spaceleagueofjustice/MEMS_Earth_Rotation_Measurement/README.md

# MEMS_Earth_Rotation_Measurement
Cheapest Earth rotation measurement ever
