spaceleagueofjustice/MEMS_Earth_Rotation_Measurement/Project_Jirka/Diagrams/Configuration.pdf

## Problems Eliminated or Reduced by This Configuration

Ground loop interference | EMI generated by motor drivers
PWM switching noise coupling into IMU electronics | Shared power supply ripple
Voltage spikes from DC motors | Current surge induced sensor instability
Mechanical cable pulling artifacts | Rotating cable torsion effects
Slip ring electrical noise | USB ground coupling
Crosstalk between motor electronics and measurement electronics | Vibrations transferred through rigid cable harnesses
Electromagnetic contamination from H-bridges | ADC noise caused by shared motor power rails
Timing instability caused by | motor control interrupts | Sensor drift amplification caused by unstable supply voltage
Microphonic vibration artifacts inside MEMS structures | Mechanical asymmetry caused by external cable drag
Random motion induced by | dangling wires | Thermal coupling between power electronics and sensors
Electrical transients during motor startup/shutdown | High-frequency switching harmonics from PWM drivers
Noise injection through common GND reference | Synchronization errors caused by mixed control and
Data corruption caused by noisy motor environments | measurement tasks
Mechanical resonance amplification through shared chassis elements | Magnetic field disturbances generated by nearby motors
Reduced long-term stability caused by mixed analog/digital | Partial elimination of non-measurement-related systematic
noise sources | actuator activity
Environmental contamination of measurements caused by uncontrolled | Improved separation between measurement domain and
artifacts | actuation domain
Improved statistical purity of | long-term MEMS measurements | Improved repeatability of experimental conditions
Improved platform symmetry and inertial balance | Reduced risk of false correlated signals between sensor axes
Reduced probability of interpreting actuator artifacts as physical phenomena | Reduced influence of power-stage thermal drift on sensor
Reduced conducted noise inside sensitive IMU circuitry | readings
Reduced structural vibration | propagation into the gyro platform | Improved conditions for FFT analysis and long-term drift
Improved suitability for Allan | variance measurements | analysis
Improved suitability for ultra-low-frequency signal analysis | Improved separation of local artifacts from potentially
global/systemic effects
