spaceleagueofjustice/MEMS_Earth_Rotation_Measurement/Project_Jaroslav/Circuit/circuit.png

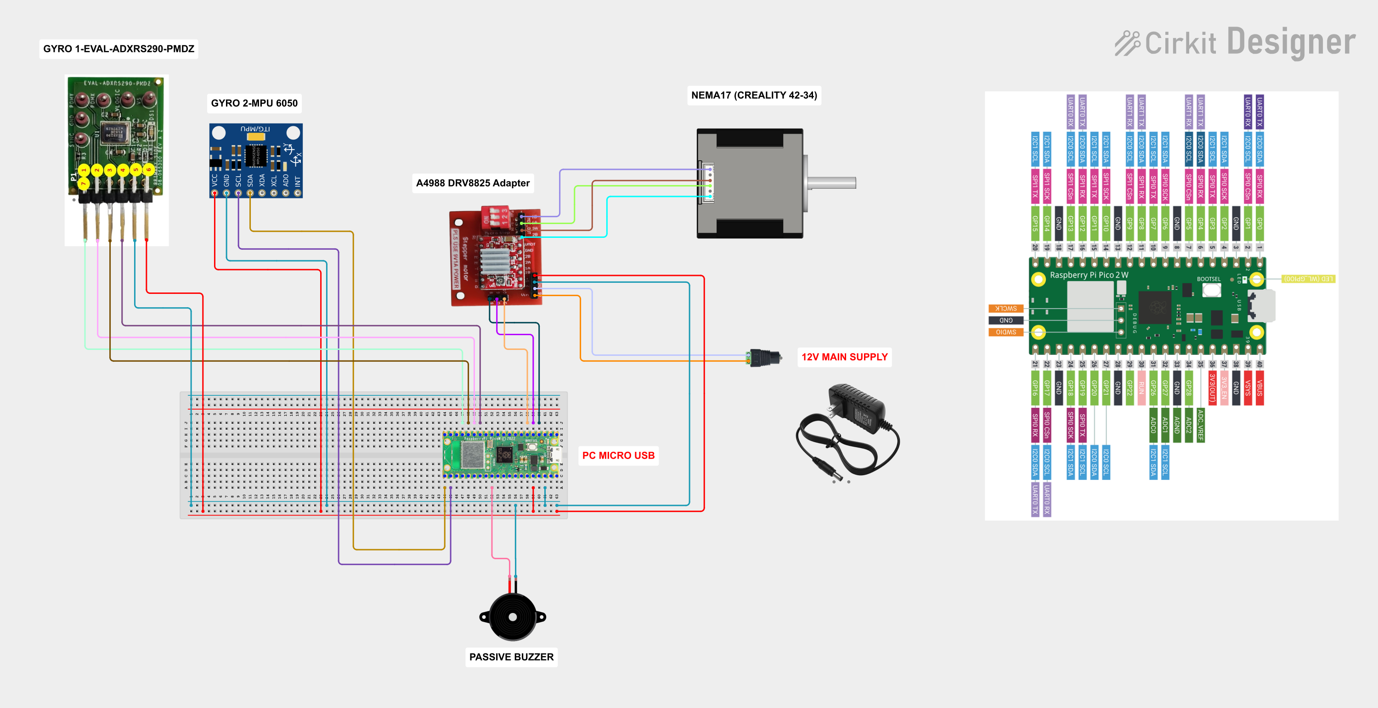
Project_Jaroslav/Circuit/circuit.png
