spaceleagueofjustice/MEMS_Earth_Rotation_Measurement/Project_Jirka/SourceCode/PC/Kalman_filter.png

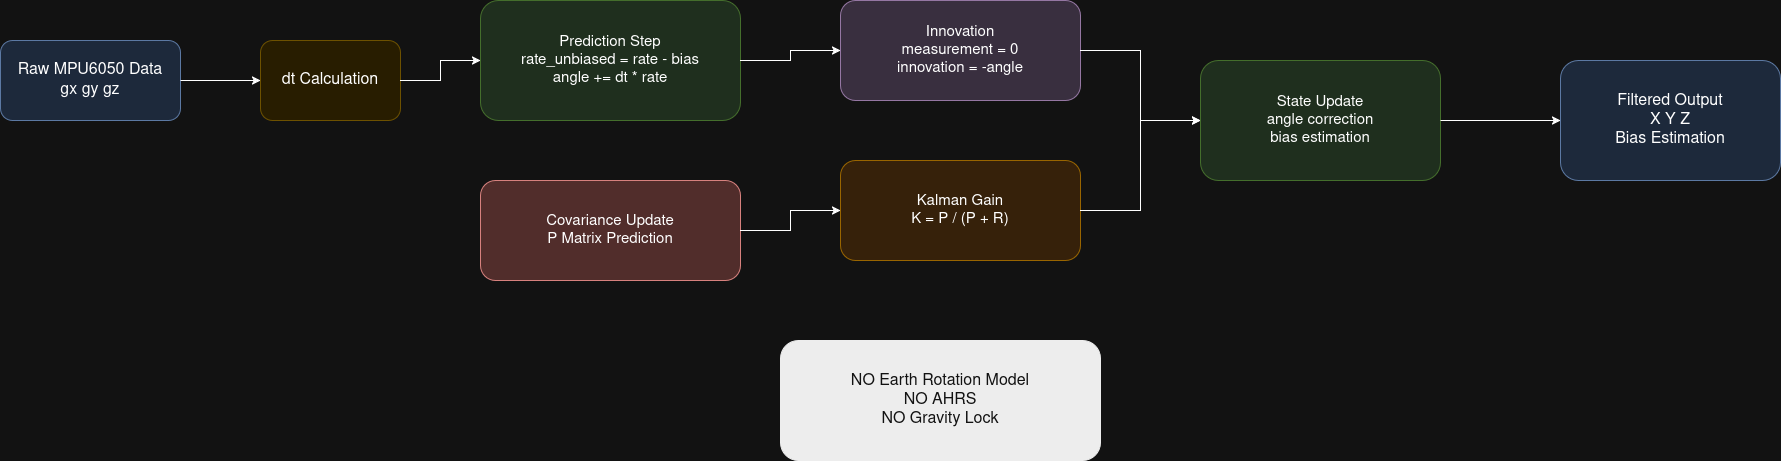
Project_Jirka/SourceCode/PC/Kalman_filter.png
