spaceleagueofjustice/MEMS_Earth_Rotation_Measurement/Project_Jaroslav/CAD-Solidworks for makers/260607180414-01_A4988 driver shield.SLDPRT

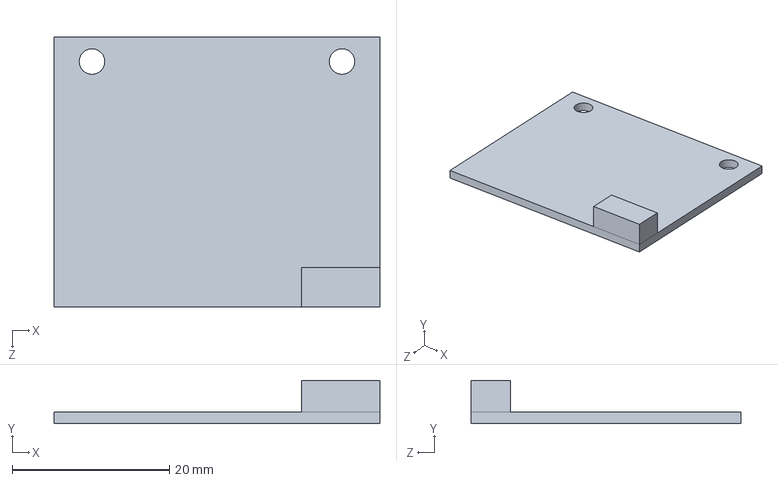
[picture p5: CAD file, 2026-07-29]
Project_Jaroslav/CAD-Solidworks for makers/260607180414-01_A4988 driver shield.SLDPRT
41.4 x 5.50 x 34.3 mm
