spaceleagueofjustice/MEMS_Earth_Rotation_Measurement/Project_Jaroslav/CAD-Solidworks for makers/260607175819-01_Stepper bracket.SLDPRT

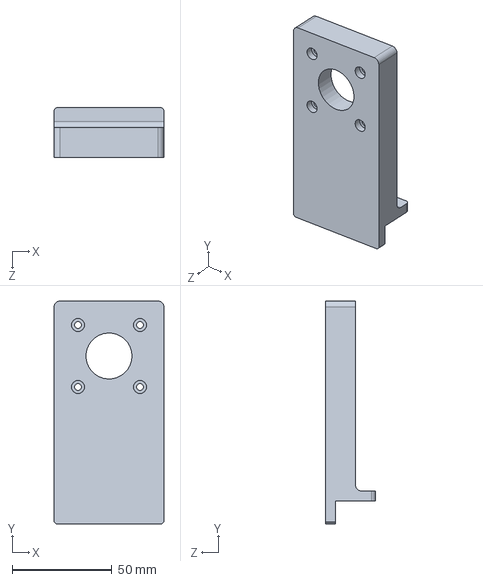
[picture p6: CAD file, 2026-07-29]
Project_Jaroslav/CAD-Solidworks for makers/260607175819-01_Stepper bracket.SLDPRT
55.0 x 111.5 x 25.0 mm
