spaceleagueofjustice/MEMS_Earth_Rotation_Measurement/Project_Jaroslav/CAD-Solidworks for makers/260607180322-01_Cable bracket rotating.SLDPRT

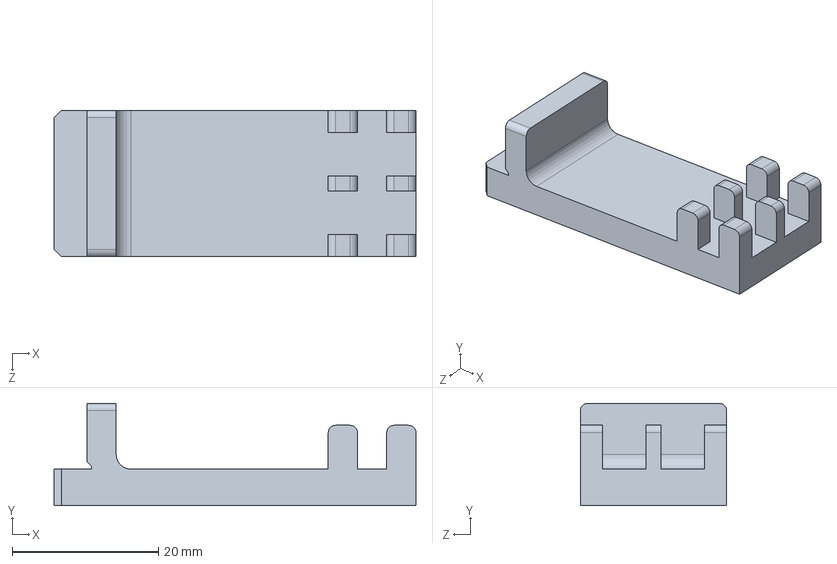
[picture p7: CAD file, 2026-07-29]
Project_Jaroslav/CAD-Solidworks for makers/260607180322-01_Cable bracket rotating.SLDPRT
49.5 x 14.0 x 20.0 mm
