spaceleagueofjustice/MEMS_Earth_Rotation_Measurement/Project_Jaroslav/CAD-Solidworks for makers/260607175956-01_NEMA 17 stepper.SLDPRT

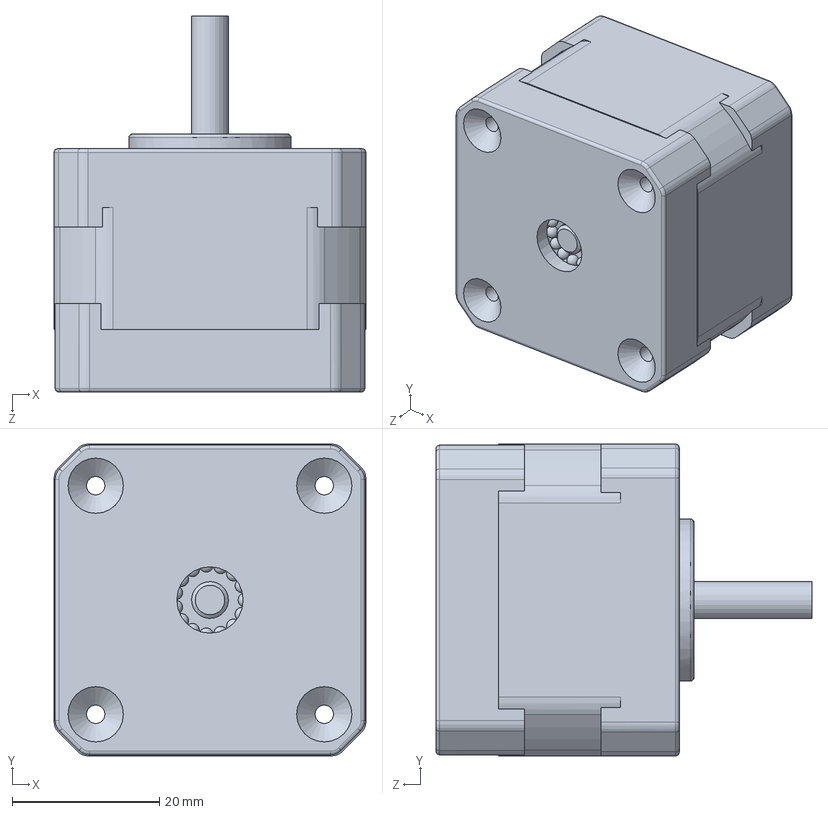
[picture p8: CAD file, 2026-07-29]
Project_Jaroslav/CAD-Solidworks for makers/260607175956-01_NEMA 17 stepper.SLDPRT
42.3 x 42.3 x 51.0 mm
