spaceleagueofjustice/MEMS_Earth_Rotation_Measurement/Project_Jaroslav/CAD-Solidworks for makers/260705133349-01_Stand.SLDPRT

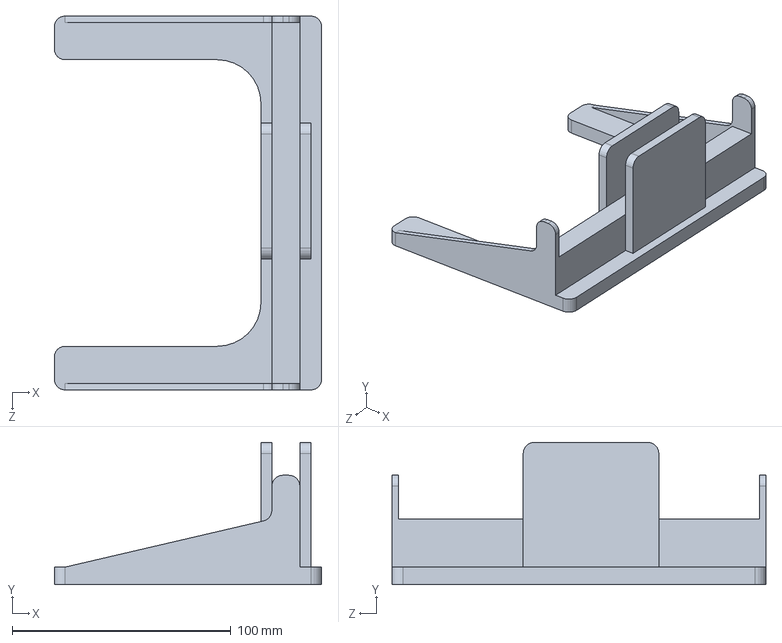
[picture p9: CAD file, 2026-07-29]
Project_Jaroslav/CAD-Solidworks for makers/260705133349-01_Stand.SLDPRT
122.3 x 65.0 x 171.0 mm
