spaceleagueofjustice/MEMS_Earth_Rotation_Measurement/Project_Jaroslav/CAD-Solidworks for makers/260607180059-01_Foot.SLDPRT

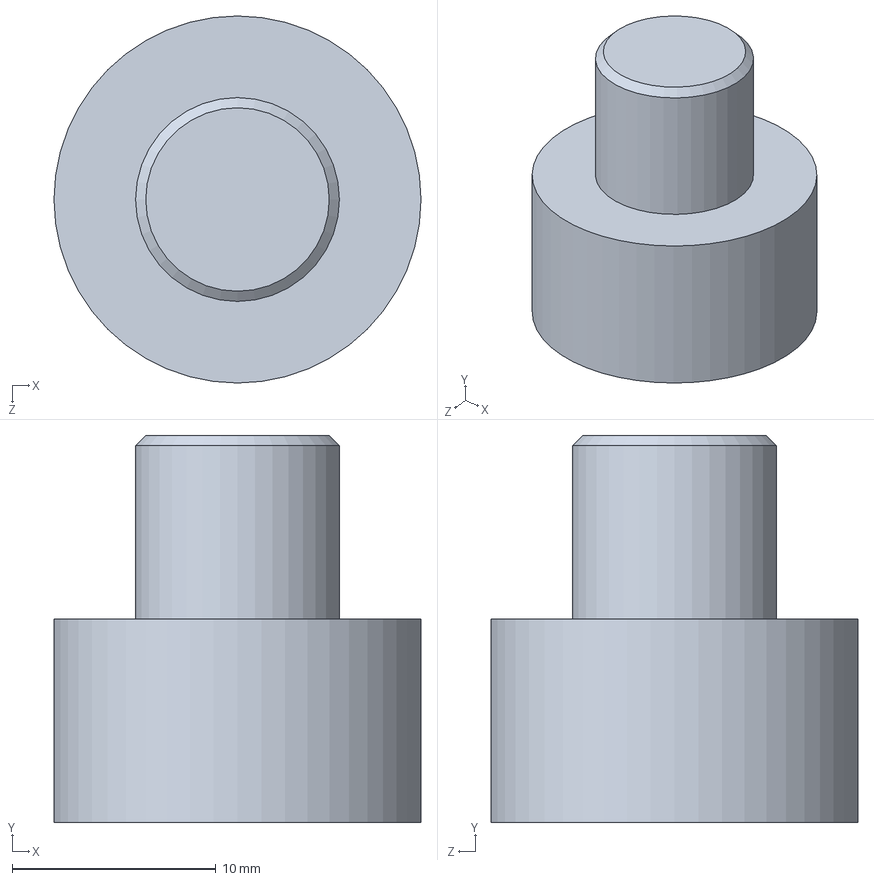
[picture p10: CAD file, 2026-07-29]
Project_Jaroslav/CAD-Solidworks for makers/260607180059-01_Foot.SLDPRT
18.0 x 19.0 x 18.0 mm
