spaceleagueofjustice/MEMS_Earth_Rotation_Measurement/Project_Jaroslav/CAD-Solidworks for makers/260607180249-01_Earth rate measurement setup ADXRS290.STEP

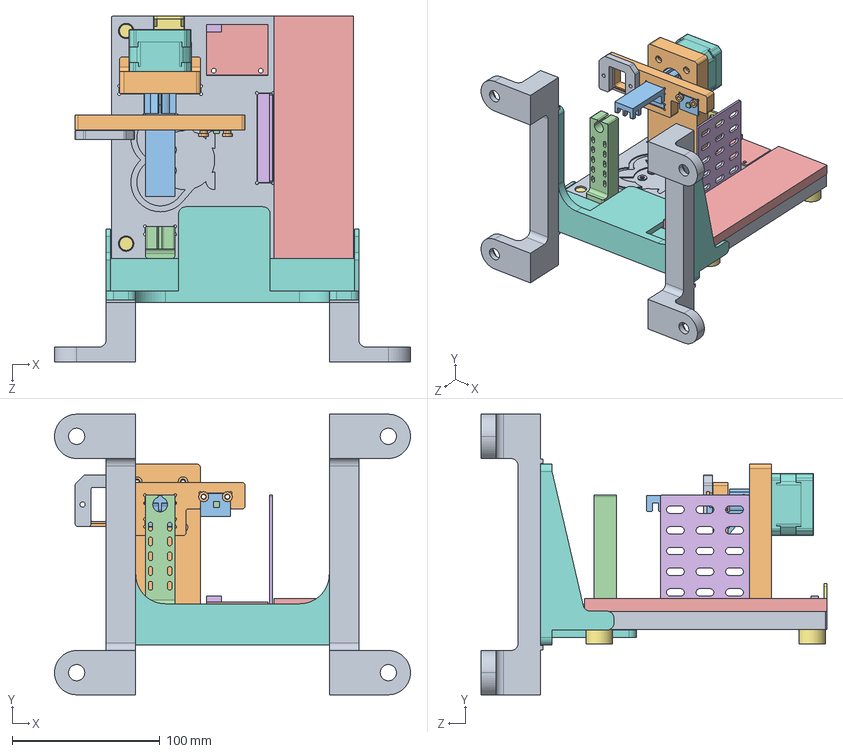
[picture p11: CAD file, 2026-07-29]
Project_Jaroslav/CAD-Solidworks for makers/260607180249-01_Earth rate measurement setup ADXRS290.STEP
241.0 x 190.0 x 234.0 mm
260607180358-01_Base plate
260607175819-01_Stepper bracket
260607180322-01_Cable bracket rotating
260607180334-01_Cable bracket fixed
260607180347-01_Bread board
260607175844-01_Partition
260607180059-01_Foot x 4
260607175956-01_NEMA 17 stepper
260608195608-01_Gyro frame-mk1
260607180303-01_Distance x 2
260607180009-01_MPU6050 gyro
260607180414-01_A4988 driver shield
260607175832-01_Power plug bracket
260705133349-01_Stand
260712184535-01_Base x 2
260716161320-01_Gyro beam V2
260716172935-01_Flange-V2
