spaceleagueofjustice/MEMS_Earth_Rotation_Measurement/Project_Jaroslav/CAD-Solidworks for makers/260607180347-01_Bread board.SLDPRT

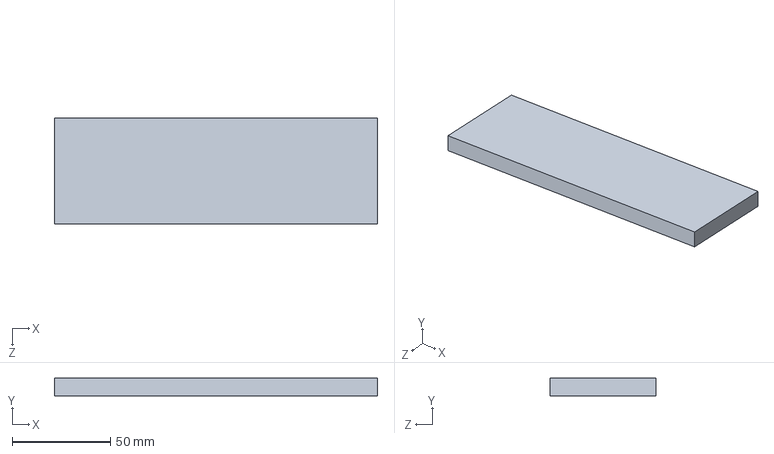
[picture p12: CAD file, 2026-07-29]
Project_Jaroslav/CAD-Solidworks for makers/260607180347-01_Bread board.SLDPRT
164.0 x 9.00 x 54.0 mm
