spaceleagueofjustice/MEMS_Earth_Rotation_Measurement/Project_Jaroslav/CAD-Solidworks for makers/260716161320-01_Gyro beam V2.SLDPRT

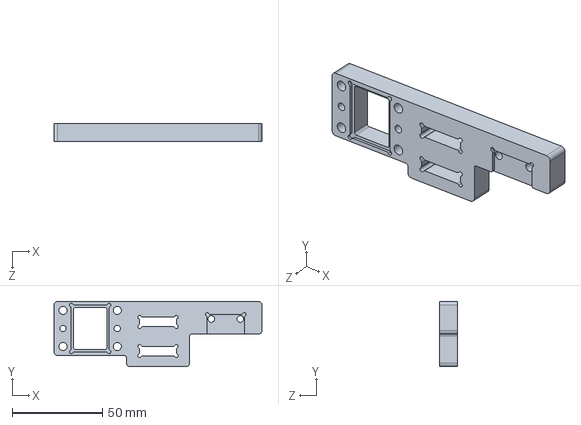
[picture p13: CAD file, 2026-07-29]
Project_Jaroslav/CAD-Solidworks for makers/260716161320-01_Gyro beam V2.SLDPRT
115.0 x 36.1 x 10.0 mm
