spaceleagueofjustice/MEMS_Earth_Rotation_Measurement/Project_Jaroslav/CAD-Solidworks for makers/260607175832-01_Power plug bracket.SLDPRT

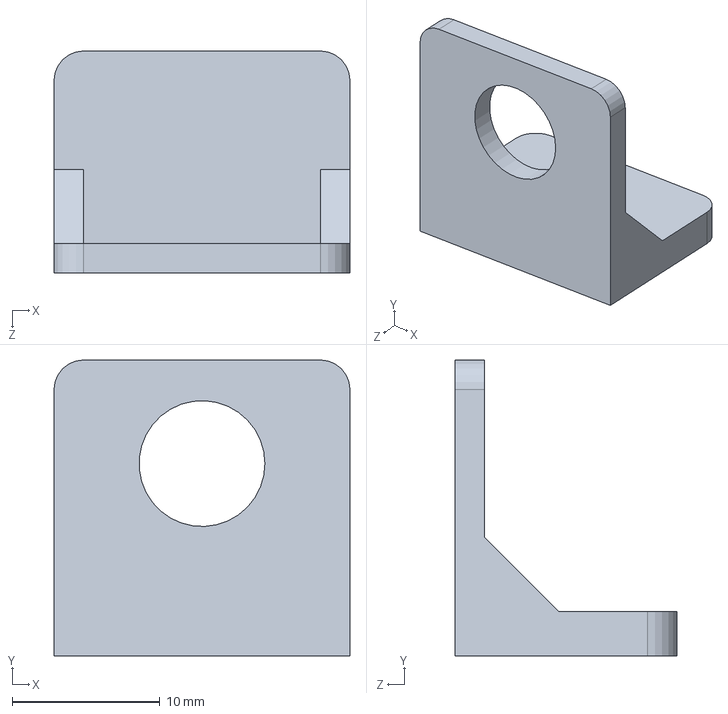
[picture p14: CAD file, 2026-07-29]
Project_Jaroslav/CAD-Solidworks for makers/260607175832-01_Power plug bracket.SLDPRT
20.0 x 20.0 x 15.0 mm
