spaceleagueofjustice/MEMS_Earth_Rotation_Measurement/Project_Jaroslav/CAD-Solidworks for makers/260607180009-01_MPU6050 gyro.SLDPRT

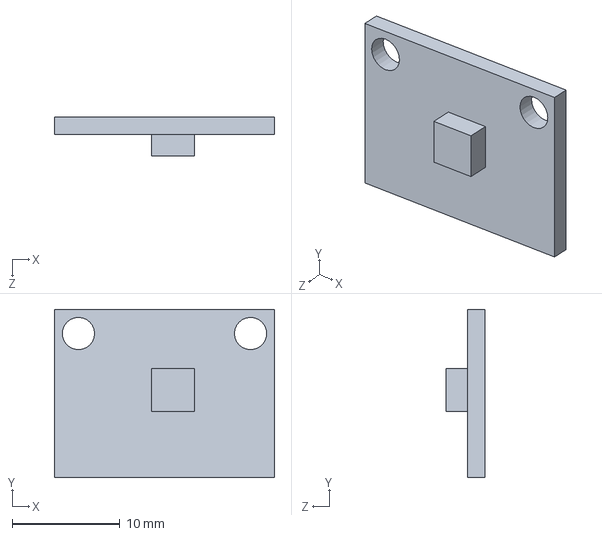
[picture p15: CAD file, 2026-07-29]
Project_Jaroslav/CAD-Solidworks for makers/260607180009-01_MPU6050 gyro.SLDPRT
20.4 x 15.7 x 3.60 mm
