spaceleagueofjustice/MEMS_Earth_Rotation_Measurement/Project_Jaroslav/CAD-Solidworks for makers/260607175844-01_Partition.SLDPRT

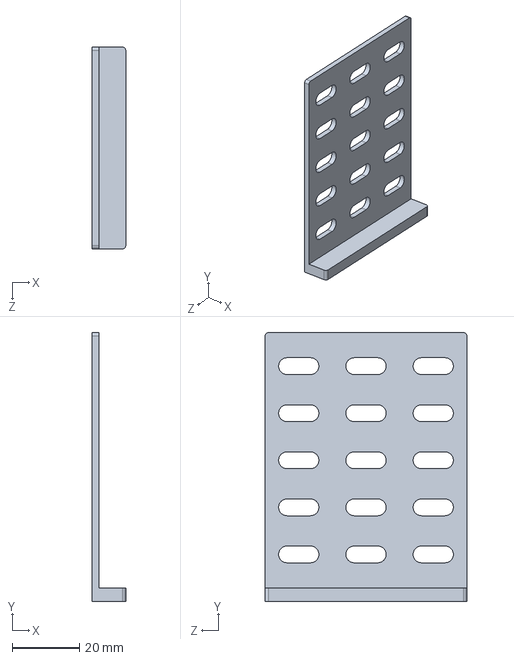
[picture p16: CAD file, 2026-07-29]
Project_Jaroslav/CAD-Solidworks for makers/260607175844-01_Partition.SLDPRT
10.0 x 80.0 x 60.0 mm
