spaceleagueofjustice/MEMS_Earth_Rotation_Measurement/Project_Jaroslav/CAD-Solidworks for makers/260607180303-01_Distance.SLDPRT

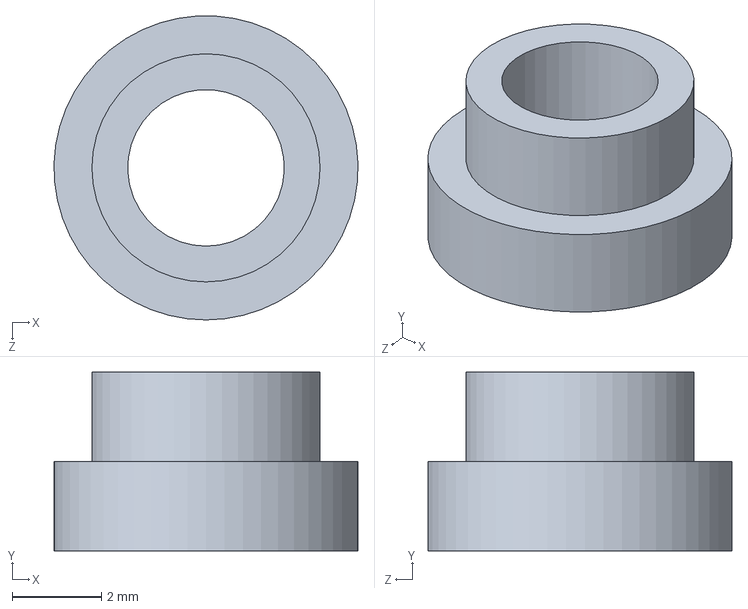
[picture p17: CAD file, 2026-07-29]
Project_Jaroslav/CAD-Solidworks for makers/260607180303-01_Distance.SLDPRT
6.80 x 4.00 x 6.79 mm
