spaceleagueofjustice/MEMS_Earth_Rotation_Measurement/Project_Jaroslav/CAD-Solidworks for makers/260712184535-01_Base.SLDPRT

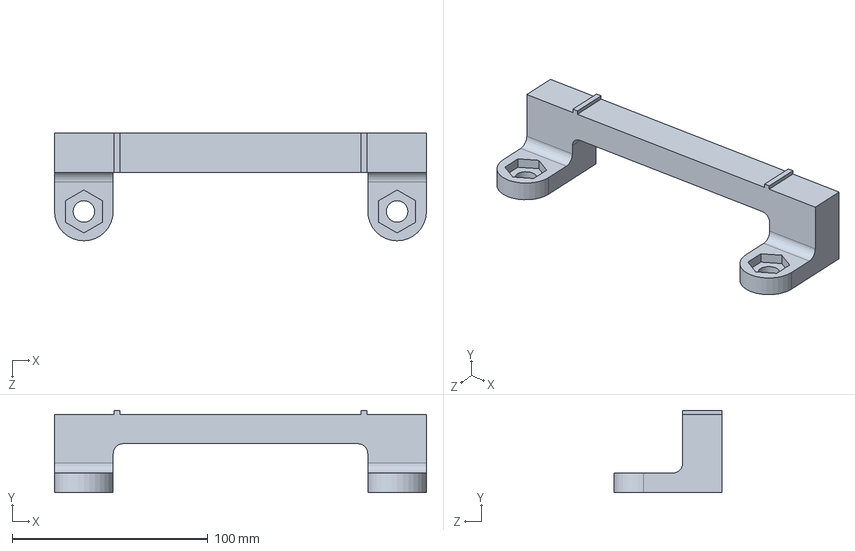
[picture p18: CAD file, 2026-07-29]
Project_Jaroslav/CAD-Solidworks for makers/260712184535-01_Base.SLDPRT
190.0 x 42.0 x 55.0 mm
