spaceleagueofjustice/MEMS_Earth_Rotation_Measurement/Project_Jaroslav/CAD-Solidworks for makers/260607180358-01_Base plate.SLDPRT

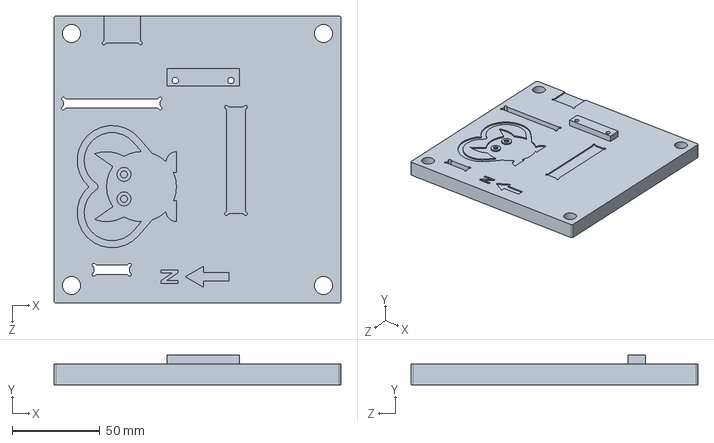
[picture p19: CAD file, 2026-07-29]
Project_Jaroslav/CAD-Solidworks for makers/260607180358-01_Base plate.SLDPRT
164.0 x 17.0 x 164.0 mm
