spaceleagueofjustice/MEMS_Earth_Rotation_Measurement/Project_Jaroslav/CAD-Solidworks for makers/260608195608-01_Gyro frame-mk1.SLDPRT

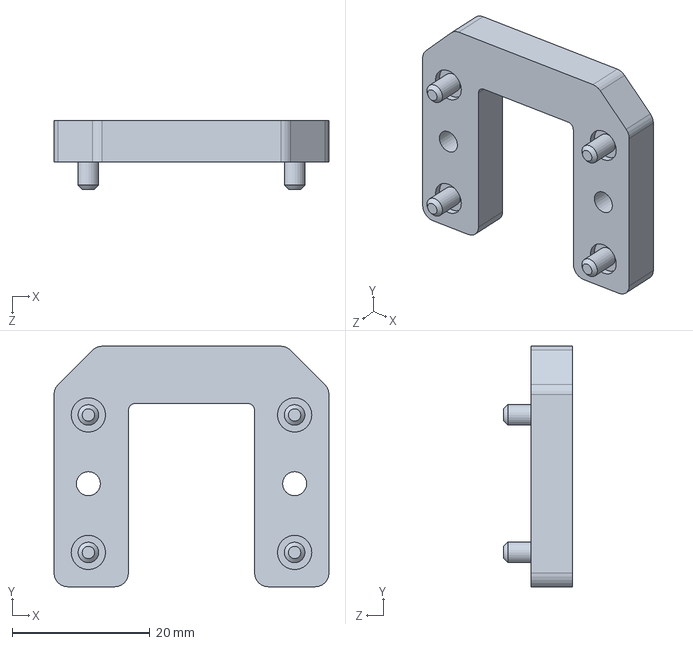
[picture p20: CAD file, 2026-07-29]
Project_Jaroslav/CAD-Solidworks for makers/260608195608-01_Gyro frame-mk1.SLDPRT
40.0 x 35.0 x 10.0 mm
