spaceleagueofjustice/MEMS_Earth_Rotation_Measurement/Project_Jaroslav/CAD-Solidworks for makers/260716172935-01_Flange-V2.SLDPRT

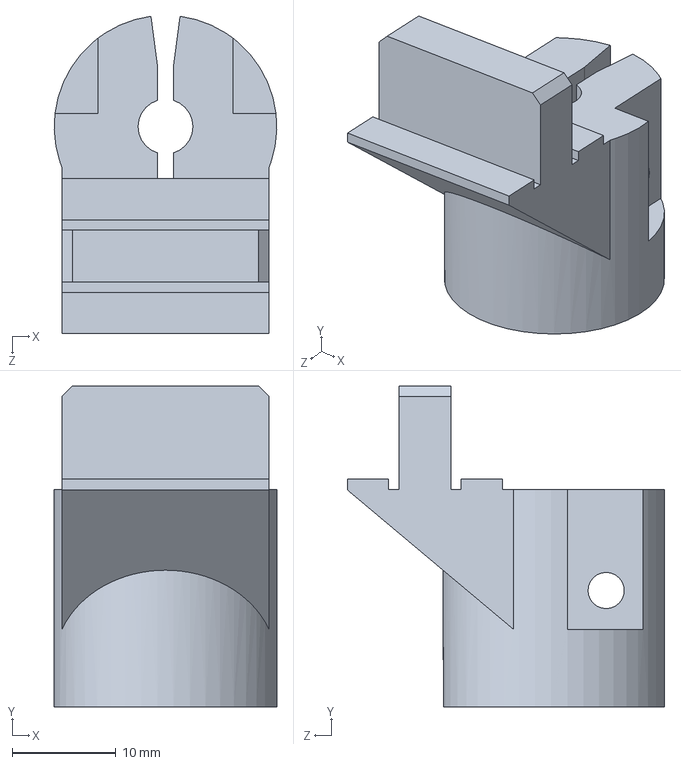
[picture p21: CAD file, 2026-07-29]
Project_Jaroslav/CAD-Solidworks for makers/260716172935-01_Flange-V2.SLDPRT
21.5 x 31.0 x 30.7 mm
