spaceleagueofjustice/MEMS_Earth_Rotation_Measurement/Project_Jaroslav/CAD-Solidworks for makers/260607180334-01_Cable bracket fixed.SLDPRT

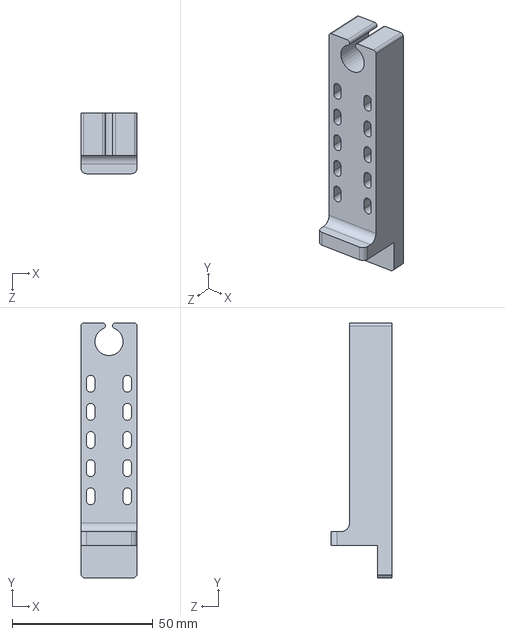
[picture p22: CAD file, 2026-07-29]
Project_Jaroslav/CAD-Solidworks for makers/260607180334-01_Cable bracket fixed.SLDPRT
20.0 x 90.6 x 21.5 mm
