spaceleagueofjustice/MEMS_Earth_Rotation_Measurement/(list of files, cad)

Other CAD files:
Project_Jaroslav/CAD-Solidworks for makers/260607180249-01_Earth rate measurement setup ADXRS290.SLDASM
Project_Jaroslav/CAD-Solidworks for makers/260607180249-01_Earth rate measurement setup ADXRS290.x_t
