spaceleagueofjustice/MEMS_Earth_Rotation_Measurement/Project_Jaroslav/Measurement data/T16/T16_evaluation.xlsx

Test ID | T16 | Azimuth-Dependence Test (Randomized 360° Step Scan) - All results
 | 0°/0°; Bathroom |  | 0°/0°; Livingroom |  | 90°/90°; Livingroom |  | 0°/0°; Livingroom; Tilt 20°/90° |  | 0°/0°; Livingroom; Magnet |  | 0°/0°; Livingroom; Tilt 10°/0°
Azimuth | T16-1 (xA-xC)/2 | T16-1 (yA-yC)/2 | T16-2 (xA-xC)/2 | T16-2 (yA-yC)/2 | T16-3 (xA-xC)/2 | T16-3 (yA-yC)/2 | T16-4 (xA-xC)/2 | T16-4 (yA-yC)/2 | T16-5 (xA-xC)/2 | T16-5 (yA-yC)/2 | T16-6 (xA-xC)/2 | T16-6 (yA-yC)/2
0 | 0.002943 | 0.002527 | 0.000879 | 0.000786 | 0.000201 | 0.005012 | 0.006448 | -0.001578 | 0.003711 | 0.000559 | 0.000625 | -0.003572
22.5 | 0.001731 | 0.003243 | 0.001109 | 0.002464 | -0.000962 | 0.004004 | 0.006706 | 0.000024 | 0.001518 | 0.001403 | 0.001786 | -0.001239
45 | 0.000837 | 0.003361 | 0.002445 | 0.000333 | -0.003128 | 0.003813 | 0.005165 | 0.004351 | 0.001739 | 0.002992 | 0.002529 | -0.000059
67.5 | 0.000856 | 0.003428 | -0.000279 | 0.003157 | -0.003887 | 0.001113 | 0.004121 | 0.008643 | 0.001673 | 0.003816 | 0.003446 | 0.001102
90 | -0.001295 | 0.003472 | -0.001533 | 0.004241 | -0.003813 | 0.001758 | -0.000408 | 0.008026 | -0.000838 | 0.002359 | 0.002040 | 0.003030
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
