spaceleagueofjustice/MEMS_Earth_Rotation_Measurement/Project_Jaroslav/Measurement data/T17/T17_evaluation.xlsx

Test ID | T16 | Azimuth-Dependence Test (Randomized 360° Step Scan) - TILT/PHASE TEST - All results
 | 0°/0° |  | 90°/0° |  | 180°/0° |  | 270°/0° |  | 0°/0° |  | 90°/0° |  | 180°/0° |  | 270°/0°
Azimuth | T17-1 (xA-xC)/2 | T17-1 (yA-yC)/2 | T17-2 (xA-xC)/2 | T17-2 (yA-yC)/2 | T17-3 (xA-xC)/2 | T17-3 (yA-yC)/2 | T17-4 (xA-xC)/2 | T17-4 (yA-yC)/2 | T17-1 tiltA | T17-1 tiltC | T17-2 tiltA | T17-2 tiltC | T17-3 tiltA | T17-3 tiltC | T17-4 tiltA | T17-4 tiltC
0 | 0.002525 | -0.000211 | 0.002815 | -0.000538 | 0.000302 | -0.000222 | 0.002331 | -0.000637 | 3.21 | 1.22 | 2.06 | 2.56 | 2.08 | 2.72 | 2.39 | 2.81
22.5 | 0.006275 | 0.003598 | 0.003687 | 0.001321 | 0.002236 | -0.001896 | 0.004055 | -0.001349 | 3.18 | 1.35 | 2.28 | 2.37 | 2.15 | 2.68 | 1.99 | 3.14
45 | 0.000965 | 0.003005 | 0.001986 | 0.000280 | 0.001272 | 0.000919 | 0.001261 | 0.002156 | 3.05 | 1.67 | 2.37 | 2.11 | 2.28 | 2.61 | 1.59 | 3.29
67.5 | 0.000062 | 0.003223 | 0.001769 | 0.003819 | 0.001633 | 0.003146 | 0.002353 | 0.001341 | 2.79 | 2.08 | 2.65 | 2.05 | 2.39 | 2.51 | 1.42 | 3.39
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
