spaceleagueofjustice/MEMS_Earth_Rotation_Measurement/Project_Jaroslav/Measurement data/T18/T18_evaluation.xlsx

Test ID | T18 | Extended Azimuth-Dependence Test (Randomized 360° Step Scan) - Bambilion points - All results
Azimuth | T18-1 (xA-xC)/2 | T18-1 (yA-yC)/2 | T18-2 (xA-xC)/2 | T18-2 (yA-yC)/2
0 | 0.000895 | 0.000194 | 0.000857 | 0.001074
5 | 0.002045 | 0.002280 | 0.002139 | 0.001611
10 | 0.002700 | 0.000008 | 0.001620 | 0.002008
15 | 0.001189 | 0.002644 | 0.002770 | 0.002476
20 | 0.003355 | 0.002949 | 0.001186 | 0.002115
25 | 0.001121 | 0.002464 | 0.000004 | 0.001298
30 | 0.000645 | 0.001321 | 0.001993 | 0.002849
35 | -0.000176 | 0.003311 | -0.001054 | 0.003539
40 | 0.002713 | 0.002704 | 0.000281 | 0.003310
45 | 0.002581 | 0.000713 | 0.000485 | 0.002219
50 | 0.003360 | 0.003116 | 0.001693 | 0.001958
55 | 0.002989 | 0.002314 | 0.000009 | 0.002530
60 | 0.001486 | 0.002057 | 0.000625 | 0.003085
65 | 0.000594 | 0.002809 | 0.001005 | 0.003135
70 | 0.002573 | 0.003367 | -0.000647 | 0.002431
75 | 0.000025 | 0.002270 | 0.000632 | 0.002877
80 | 0.001684 | 0.004532 | 0.000454 | 0.002025
85 | -0.000764 | 0.003186 | -0.000365 | 0.001035
90 | -0.000950 | 0.002779 | -0.000195 | 0.002217
95 | -0.000487 | 0.003959 | 0.000011 | 0.002585
100 | -0.001724 | 0.002246 | 0.001157 | 0.001504
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
