spaceleagueofjustice/MEMS_Earth_Rotation_Measurement/Project_Jaroslav/Measurement data/T19/T19-1/T19-1_mereni_data.csv

smer | cyklus | cilovy_azimut | skutecne_natoceni | jump_deg | trim | xA | yA | tA | axA | ayA | xC | yC | tC | axC | ayC
CCW | 1 | 340 | -20.00 | -20.00 | 50 | -0.46089990 | 0.69034992 | 22.30 | 0.058813 | 0.025867 | -0.46169990 | 0.69240000 | 22.30 | 0.027085 | -0.013323
CW | 2 | 120 | 120.00 | 140.00 | 50 | -0.45769996 | 0.70100016 | 22.29 | 0.041594 | -0.017988 | -0.46944996 | 0.70410016 | 22.30 | 0.041858 | 0.031152
CW | 3 | 200 | 200.00 | 80.00 | 50 | -0.47195000 | 0.70190000 | 22.31 | 0.017664 | 0.002185 | -0.46880000 | 0.70010020 | 22.31 | 0.066545 | 0.011755
CW | 4 | 340 | 340.00 | 140.00 | 50 | -0.47270010 | 0.69335016 | 22.29 | 0.058633 | 0.026462 | -0.45704980 | 0.69120030 | 22.30 | 0.028113 | -0.013188
CW | 5 | 150 | 150.00 | 150.00 | 50 | -0.46459980 | 0.69050020 | 22.32 | 0.029819 | -0.015627 | -0.46199990 | 0.69170000 | 22.31 | 0.054958 | 0.028296
CW | 6 | 210 | 210.00 | 60.00 | 50 | -0.46539976 | 0.68650000 | 22.31 | 0.017637 | 0.006624 | -0.46310000 | 0.70395000 | 22.34 | 0.066101 | 0.007703
CW | 7 | 270 | 270.00 | 60.00 | 50 | -0.46654996 | 0.69244990 | 22.30 | 0.031155 | 0.028267 | -0.47870020 | 0.69410016 | 22.30 | 0.057747 | -0.014219
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
