spaceleagueofjustice/MEMS_Earth_Rotation_Measurement/Project_Jaroslav/Measurement data/T19/T19-1/T19-1_mereni_summary.csv

smer | azimut | n | xA_prumer | xC_prumer | diffx_prumer | yA_prumer | yC_prumer | diffy_prumer | tA_prumer | tC_prumer | difft_prumer | axA_prumer | axC_prumer | diffax_prumer | ayA_prumer | ayC_prumer | diffay_prumer
CCW | 0 | 6 | -0,46680824 | -0,46369156 | -0,00311667 | 0,6570333 | 0,66035836 | -0,00332505 | 22,98 | 22,98 | 0 | 0,06056641 | 0,01901245 | 0,04155396 | 0,01924805 | -0,00678833 | 0,02603638
CCW | 10 | 2 | -0,46197504 | -0,4631248 | 0,00114977 | 0,63084996 | 0,6317 | -0,00085002 | 23,41 | 23,4 | 0 | 0,06229858 | 0,0153772 | 0,04692139 | 0,0142688 | -0,0024353 | 0,0167041
CCW | 20 | 8 | -0,4683062 | -0,46589992 | -0,00240624 | 0,64973752 | 0,6499125 | -0,00017494 | 23,13 | 23,14 | -0,01 | 0,06424865 | 0,01545532 | 0,04879333 | 0,01080322 | 0,00135742 | 0,0094458
CCW | 30 | 7 | -0,46841416 | -0,46219276 | -0,00622138 | 0,6632786 | 0,66360724 | -0,00032866 | 22,88 | 22,86 | 0,02 | 0,0649449 | 0,01570208 | 0,04924282 | 0,00641915 | 0,00608782 | 0,00033133
CCW | 40 | 6 | -0,46866656 | -0,45709988 | -0,01156667 | 0,65928332 | 0,6470917 | 0,01219165 | 23,08 | 23,09 | 0 | 0,06457683 | 0,01573934 | 0,04883749 | 0,00190063 | 0,01002889 | -0,00812826
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
