spaceleagueofjustice/MEMS_Earth_Rotation_Measurement/Project_Jaroslav/Measurement data/T19/T19-2/T19-2_mereni_summary.csv

smer | azimut | n | xA_prumer | xC_prumer | diffx_prumer | yA_prumer | yC_prumer | diffy_prumer | tA_prumer | tC_prumer | difft_prumer | axA_prumer | axC_prumer | diffax_prumer | ayA_prumer | ayC_prumer | diffay_prumer
CCW | 0 | 4 | -0,43295000 | -0,42950000 | -0,00345004 | 0,46612496 | 0,46388740 | 0,00223753 | 26,54 | 26,52 | 0,02 | 0,04889160 | 0,02038574 | 0,02850586 | 0,02686340 | -0,01932068 | 0,04618408
CCW | 10 | 4 | -0,43210000 | -0,42482500 | -0,00727502 | 0,50597492 | 0,50201250 | 0,00396246 | 26,03 | 26,00 | 0,03 | 0,05368592 | 0,01764404 | 0,03604187 | 0,02417542 | -0,01630981 | 0,04048523
CCW | 20 | 6 | -0,43735000 | -0,43323330 | -0,00411671 | 0,50755830 | 0,50234156 | 0,00521672 | 25,87 | 25,87 | -0,01 | 0,05810059 | 0,01437948 | 0,04372112 | 0,02041545 | -0,01320068 | 0,03361613
CCW | 30 | 7 | -0,43709280 | -0,43072136 | -0,00637144 | 0,51547856 | 0,50846430 | 0,00701427 | 25,86 | 25,85 | 0,00 | 0,05966134 | 0,01134556 | 0,04831578 | 0,01684710 | -0,00867187 | 0,02551897
CCW | 40 | 5 | -0,43751992 | -0,43280000 | -0,00471994 | 0,52094000 | 0,51586010 | 0,00507992 | 25,79 | 25,81 | -0,01 | 0,06164063 | 0,00982666 | 0,05181397 | 0,01207129 | -0,00434814 | 0,01641943
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
