spaceleagueofjustice/MEMS_Earth_Rotation_Measurement/Project_Jaroslav/Measurement data/T19/T19-3/T19-3_mereni_data.csv

smer | cyklus | cilovy_azimut | skutecne_natoceni | jump_deg | trim | xA | yA | tA | axA | ayA | xC | yC | tC | axC | ayC
CCW | 1 | 330 | -30.00 | -30.00 | 50 | -0.51450010 | 0.70115000 | 23.87 | 0.037737 | 0.032507 | -0.47735012 | 0.69655016 | 23.91 | 0.038794 | -0.022434
CCW | 2 | 300 | -60.00 | -30.00 | 50 | -0.48000008 | 0.65744996 | 23.96 | 0.025813 | 0.029146 | -0.47205012 | 0.64829980 | 24.00 | 0.052075 | -0.019138
CW | 3 | 30 | 30.00 | 90.00 | 50 | -0.47214988 | 0.64004990 | 24.02 | 0.062969 | 0.018591 | -0.46064988 | 0.62040000 | 24.04 | 0.015215 | -0.008423
CCW | 4 | 210 | -150.00 | -180.00 | 50 | -0.46054990 | 0.61114990 | 24.00 | 0.014775 | -0.008596 | -0.45079992 | 0.60835000 | 24.07 | 0.062385 | 0.018364
CW | 5 | 280 | -80.00 | 70.00 | 50 | -0.44740000 | 0.60334984 | 24.08 | 0.017861 | 0.023718 | -0.43619990 | 0.60460000 | 24.10 | 0.059583 | -0.012861
CCW | 6 | 220 | -140.00 | -60.00 | 50 | -0.43679996 | 0.60130030 | 24.12 | 0.010979 | -0.004255 | -0.44249996 | 0.59384990 | 24.11 | 0.065486 | 0.013633
CCW | 7 | 200 | -160.00 | -20.00 | 50 | -0.44549988 | 0.58340016 | 24.17 | 0.018877 | -0.012234 | -0.42929996 | 0.59590000 | 24.15 | 0.057473 | 0.023088
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
