spaceleagueofjustice/MEMS_Earth_Rotation_Measurement/Project_Jaroslav/Measurement data/T19/T19-3/T19-3_mereni_summary.csv

smer | azimut | n | xA_prumer | xC_prumer | diffx_prumer | yA_prumer | yC_prumer | diffy_prumer | tA_prumer | tC_prumer | difft_prumer | axA_prumer | axC_prumer | diffax_prumer | ayA_prumer | ayC_prumer | diffay_prumer
CCW | 0 | 7 | -0,45869280 | -0,45155708 | -0,00713572 | 0,60627852 | 0,60917852 | -0,00290000 | 24,17 | 24,17 | 0,00 | 0,07101528 | 0,00409703 | 0,06691825 | 0,00608224 | 0,00591030 | 0,00017194
CCW | 10 | 5 | -0,45475990 | -0,45041984 | -0,00434005 | 0,59230008 | 0,59326992 | -0,00096989 | 24,49 | 24,50 | -0,01 | 0,06927100 | 0,00450391 | 0,06476709 | -0,00043555 | 0,01137353 | -0,01180908
CCW | 20 | 5 | -0,45037990 | -0,44708996 | -0,00328994 | 0,59837990 | 0,60330990 | -0,00493002 | 24,35 | 24,33 | 0,01 | 0,06883838 | 0,00565479 | 0,06318360 | -0,00507520 | 0,01635108 | -0,02142627
CCW | 30 | 4 | -0,44847500 | -0,44643748 | -0,00203753 | 0,59096244 | 0,59472500 | -0,00376254 | 24,60 | 24,59 | 0,01 | 0,06651734 | 0,00859009 | 0,05792725 | -0,01044556 | 0,02175903 | -0,03220459
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
