spaceleagueofjustice/MEMS_Earth_Rotation_Measurement/Project_Jaroslav/Measurement data/T19/T19-4/T19-4_mereni_data.csv

smer | cyklus | cilovy_azimut | skutecne_natoceni | jump_deg | trim | xA | yA | tA | axA | ayA | xC | yC | tC | axC | ayC
CCW | 1 | 260 | -100.00 | -100.00 | 50 | -0.46769984 | 0.69840040 | 22.36 | 0.035518 | 0.039150 | -0.47035000 | 0.69430000 | 22.43 | 0.045579 | -0.025679
CCW | 2 | 220 | -140.00 | -40.00 | 50 | -0.46909980 | 0.70045008 | 22.38 | 0.014319 | 0.028450 | -0.46864990 | 0.70060000 | 22.34 | 0.064961 | -0.014944
CCW | 3 | 40 | -320.00 | -180.00 | 50 | -0.47174990 | 0.69394990 | 22.41 | 0.064373 | -0.015144 | -0.47085000 | 0.69534992 | 22.39 | 0.015325 | 0.028647
CW | 4 | 80 | -280.00 | 40.00 | 50 | -0.47450008 | 0.69820000 | 22.40 | 0.045469 | -0.025974 | -0.47305004 | 0.69259990 | 22.34 | 0.035625 | 0.038923
CCW | 5 | 350 | -370.00 | -90.00 | 50 | -0.46394976 | 0.70540000 | 22.37 | 0.072449 | 0.011387 | -0.47540024 | 0.69315016 | 22.36 | 0.008564 | 0.001143
CCW | 6 | 300 | -60.00 | -60.00 | 50 | -0.47980020 | 0.68055000 | 22.35 | 0.058894 | 0.034663 | -0.47119996 | 0.69555020 | 22.37 | 0.024326 | -0.021602
CW | 7 | 50 | 50.00 | 110.00 | 50 | -0.46819996 | 0.68035010 | 22.33 | 0.060664 | -0.019448 | -0.47089996 | 0.68175020 | 22.44 | 0.021851 | 0.031375
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
