spaceleagueofjustice/MEMS_Earth_Rotation_Measurement/Project_Jaroslav/Measurement data/T19/T19-4/T19-4_mereni_summary.csv

smer | azimut | n | xA_prumer | xC_prumer | diffx_prumer | yA_prumer | yC_prumer | diffy_prumer | tA_prumer | tC_prumer | difft_prumer | axA_prumer | axC_prumer | diffax_prumer | ayA_prumer | ayC_prumer | diffay_prumer
CCW | 0 | 5 | -0,44891996 | -0,44738990 | -0,00153005 | 0,53713000 | 0,53572000 | 0,00141001 | 25,31 | 25,32 | -0,01 | 0,06950244 | 0,00391455 | 0,06558788 | 0,00435010 | 0,00518799 | -0,00083789
CCW | 10 | 7 | -0,46565704 | -0,45829276 | -0,00736427 | 0,61866424 | 0,62289284 | -0,00422859 | 23,71 | 23,71 | -0,00 | 0,07120640 | 0,00663086 | 0,06457554 | -0,00075579 | 0,01206857 | -0,01282436
CCW | 20 | 6 | -0,45398320 | -0,44673332 | -0,00724989 | 0,55946668 | 0,54852516 | 0,01094151 | 24,98 | 24,97 | 0,01 | 0,06764161 | 0,00608927 | 0,06155234 | -0,00702799 | 0,01676636 | -0,02379435
CCW | 30 | 8 | -0,46023736 | -0,45189370 | -0,00834367 | 0,58181250 | 0,58182500 | -0,00001252 | 24,44 | 24,46 | -0,02 | 0,06648284 | 0,00971130 | 0,05677154 | -0,01236084 | 0,02221497 | -0,03457580
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
