spaceleagueofjustice/MEMS_Earth_Rotation_Measurement/Project_Jaroslav/Measurement data/T19/T19-5/T19-5_evaluation.xlsx

Sheet: Main
Test ID | T19-5 | Test (Randomized 360° Step Scan) |  |  |  |  |  |  |  | Orientation
Mount azimuth |  |  | ? | ° | Description/title: | Code: |  |  |  |  |  | ?
Arm start azimuth |  |  | 180 najdi sever | ° | - Rotace ramene CW/CCW - Náhodné azimuty pro celých 360° - Azimut ramene při startu vžy 0° (sever) - Kalibrace do nulového náklony do 0,5° (přibližně) - Oprava xA-xC na správný směr xC-xA | - _najdi sever 3-move to azimuth-AC-watchdog.py - HORIZONTAL slepý test 360-kontrola accel-lepší csv-azimut parametr-fixed trim settle-s navratem do A-antibacklash-CW-CCW-I2Coprava-název testu-teplota-oprava2-watchdog.py
Measuring plane deviation/slope azimuth |  |  | 0 | °/°
Location |  |  | living room
Theoretical earth rotation rate |  |  | 0.004178 | °/s
Latitude |  |  | 49 | °
Theoretical earth rotation rate at latitude cos(lat) |  |  | 0.002741 | °/s
Azimuth step |  |  | 10 | °
Azimuth step count |  |  | 36
Rotation direction |  |  | CC/CCW |  |  | min X | min Y | max X | max Y | | |  | 180°
Cycles |  |  | 480
Samples per position |  |  | 200
Trim |  |  | 50 |  |  |  |  |  |  | | |  | ↓
Cable protection |  |  | 400 | ° |  | -0.005733 | -0.005920 | 0.004458 | 0.005567
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
