spaceleagueofjustice/MEMS_Earth_Rotation_Measurement/Project_Jaroslav/Measurement data/T19/T19-5/T19-5_mereni_data.csv

smer | cyklus | cilovy_azimut | skutecne_natoceni | jump_deg | trim | xA | yA | tA | axA | ayA | xC | yC | tC | axC | ayC
CW | 1 | 0 | 0.00 | 0.00 | 50 | -0.44289996 | 0.54200030 | 25.29 | 0.037795 | 0.039946 | -0.46234990 | 0.52624992 | 25.23 | 0.035430 | -0.030679
CCW | 2 | 350 | -10.00 | -10.00 | 50 | -0.43885000 | 0.54020036 | 25.23 | 0.032031 | 0.039487 | -0.44869984 | 0.53590000 | 25.18 | 0.042107 | -0.029988
CW | 3 | 100 | 100.00 | 110.00 | 50 | -0.45784992 | 0.54605016 | 25.21 | 0.071665 | -0.003047 | -0.44874984 | 0.55025010 | 25.14 | 0.003193 | 0.011033
CW | 4 | 230 | 230.00 | 130.00 | 50 | -0.45224990 | 0.54050016 | 25.20 | 0.009377 | -0.017859 | -0.44864992 | 0.53920020 | 25.24 | 0.065466 | 0.025918
CW | 5 | 270 | 270.00 | 40.00 | 50 | -0.44994992 | 0.55925008 | 25.21 | 0.001274 | 0.005559 | -0.46004988 | 0.54055030 | 25.24 | 0.072336 | 0.004011
CW | 6 | 300 | 300.00 | 30.00 | 50 | -0.43980008 | 0.56180008 | 25.19 | 0.007405 | 0.022559 | -0.45224970 | 0.54300016 | 25.19 | 0.066746 | -0.013662
CCW | 7 | 120 | 120.00 | -180.00 | 50 | -0.45369990 | 0.54515000 | 25.19 | 0.068435 | -0.013530 | -0.44590000 | 0.54205024 | 25.11 | 0.006489 | 0.022273
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
