spaceleagueofjustice/MEMS_Earth_Rotation_Measurement/Project_Jaroslav/Measurement data/T19/T19-5/T19-5_mereni_summary.csv

smer | azimut | n | xA_prumer | xC_prumer | diffx_prumer | yA_prumer | yC_prumer | diffy_prumer | tA_prumer | tC_prumer | difft_prumer | axA_prumer | axC_prumer | diffax_prumer | ayA_prumer | ayC_prumer | diffay_prumer
CCW | 0 | 9 | -0,44302770 | -0,45056104 | 0,00753334 | 0,53467780 | 0,53335560 | 0,00132221 | 25,30 | 25,32 | -0,02 | 0,03744982 | 0,03622721 | 0,00122261 | 0,04047553 | -0,03052219 | 0,07099772
CCW | 10 | 6 | -0,45194160 | -0,45337500 | 0,00143340 | 0,53403330 | 0,53534176 | -0,00130844 | 25,34 | 25,33 | 0,01 | 0,04322225 | 0,02975545 | 0,01346680 | 0,03993774 | -0,02985148 | 0,06978922
CCW | 20 | 8 | -0,44447500 | -0,44879364 | 0,00431865 | 0,53838752 | 0,53968140 | -0,00129384 | 25,31 | 25,30 | 0,01 | 0,04955414 | 0,02439819 | 0,02515594 | 0,03809784 | -0,02826813 | 0,06636596
CCW | 30 | 6 | -0,44425000 | -0,44999992 | 0,00574994 | 0,53474170 | 0,53765004 | -0,00290835 | 25,38 | 25,37 | 0,01 | 0,05535970 | 0,01843018 | 0,03692952 | 0,03546224 | -0,02564046 | 0,06110270
CCW | 40 | 6 | -0,44434168 | -0,45054992 | 0,00620827 | 0,53045004 | 0,53206664 | -0,00161660 | 25,39 | 25,37 | 0,03 | 0,05980998 | 0,01291992 | 0,04689006 | 0,03213948 | -0,02191650 | 0,05405599
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
