spaceleagueofjustice/MEMS_Earth_Rotation_Measurement/Project_Jaroslav/Measurement data/T19/T19-6/T19-6_mereni_data.csv

smer | cyklus | cilovy_azimut | skutecne_natoceni | jump_deg | trim | xA | yA | tA | axA | ayA | xC | yC | tC | axC | ayC
CCW | 1 | 250 | -110.00 | -110.00 | 200 | -0.48432536 | 0.68484100 | 24.30 | 0.034807 | 0.037900 | -0.46565896 | 0.65888270 | 24.34 | 0.044471 | -0.027198
CCW | 2 | 80 | -280.00 | -170.00 | 200 | -0.45143290 | 0.63038350 | 24.47 | 0.038848 | -0.027862 | -0.44150780 | 0.60135890 | 24.52 | 0.040276 | 0.037946
CCW | 3 | 290 | -70.00 | -70.00 | 200 | -0.43894116 | 0.58585936 | 24.60 | 0.057091 | 0.033322 | -0.42864912 | 0.57774200 | 24.60 | 0.022749 | -0.022570
CW | 4 | 100 | 100.00 | 170.00 | 200 | -0.42076670 | 0.57364152 | 24.62 | 0.027216 | -0.025403 | -0.42109944 | 0.56662508 | 24.68 | 0.051278 | 0.035413
CCW | 5 | 40 | 40.00 | -60.00 | 200 | -0.41866660 | 0.55666684 | 24.77 | 0.058793 | -0.019760 | -0.41394976 | 0.56112540 | 24.72 | 0.018238 | 0.031475
CCW | 6 | 330 | -30.00 | -70.00 | 200 | -0.41520008 | 0.55659170 | 24.75 | 0.069400 | 0.015883 | -0.41100010 | 0.55339984 | 24.80 | 0.008787 | -0.004210
CCW | 7 | 250 | -110.00 | -80.00 | 200 | -0.40884170 | 0.55585880 | 24.79 | 0.033891 | 0.037952 | -0.41341664 | 0.55611632 | 24.80 | 0.043419 | -0.027126
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
