spaceleagueofjustice/MEMS_Earth_Rotation_Measurement/Project_Jaroslav/Measurement data/T19/T19-6/T19-6_mereni_summary.csv

smer | azimut | n | xA_prumer | xC_prumer | diffx_prumer | yA_prumer | yC_prumer | diffy_prumer | tA_prumer | tC_prumer | difft_prumer | axA_prumer | axC_prumer | diffax_prumer | ayA_prumer | ayC_prumer | diffay_prumer
CCW | 0 | 6 | -0,43255648 | -0,42962740 | -0,00292906 | 0,53183170 | 0,53508468 | -0,00325298 | 25,36 | 25,34 | 0,02 | 0,06977756 | 0,00600830 | 0,06376926 | -0,00193977 | 0,01174079 | -0,01368056
CCW | 10 | 3 | -0,44088840 | -0,43659630 | -0,00429207 | 0,52208550 | 0,52153564 | 0,00054985 | 25,41 | 25,41 | 0,00 | 0,06769816 | 0,00733154 | 0,06036662 | -0,00743069 | 0,01735745 | -0,02478814
CCW | 20 | 5 | -0,43396290 | -0,43071940 | -0,00324354 | 0,53068810 | 0,52807330 | 0,00261480 | 25,39 | 25,38 | 0,02 | 0,06573559 | 0,01061662 | 0,05511898 | -0,01305428 | 0,02209701 | -0,03515129
CCW | 30 | 3 | -0,42907728 | -0,42276608 | -0,00631121 | 0,54128560 | 0,54223008 | -0,00094450 | 25,29 | 25,29 | 0,01 | 0,06285834 | 0,01372993 | 0,04912842 | -0,01686361 | 0,02636244 | -0,04322605
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
