spaceleagueofjustice/MEMS_Earth_Rotation_Measurement/Project_Jaroslav/Measurement data/T16/T16-1/T16-1_mereni_data.csv

smer | cyklus | cilovy_azimut | skutecne_natoceni | jump_deg | trim | xA | yA | tA | axA | ayA | xC | yC | tC | axC | ayC
CCW | 1 | 225 | -135.00 | -135.00 | 50 | -0.38309992 | 0.62795010 | 25.23 | 0.035305 | -0.007637 | -0.36160000 | 0.62170000 | 25.30 | 0.058462 | -0.001582
CW | 2 | 270 | -90.00 | 45.00 | 50 | -0.35004988 | 0.58495010 | 25.30 | 0.037551 | 0.001311 | -0.34684990 | 0.59039990 | 25.34 | 0.058123 | -0.010432
CW | 3 | 337.5 | -22.50 | 67.50 | 50 | -0.32145004 | 0.56595004 | 25.38 | 0.049248 | 0.007668 | -0.31089990 | 0.54545016 | 25.47 | 0.045171 | -0.016401
CCW | 4 | 202.5 | -157.50 | -135.00 | 50 | -0.30654994 | 0.54260016 | 25.48 | 0.037327 | -0.011882 | -0.30620006 | 0.54060024 | 25.58 | 0.056726 | 0.002490
CW | 5 | 202.5 | -157.50 | 0.00 | 50 | -0.28470010 | 0.52070000 | 25.60 | 0.036162 | -0.011858 | -0.29310010 | 0.52960000 | 25.59 | 0.057915 | 0.002544
CCW | 6 | 180 | -180.00 | -22.50 | 50 | -0.27909996 | 0.51859990 | 25.60 | 0.038591 | -0.015149 | -0.28830008 | 0.50719976 | 25.63 | 0.051943 | 0.005134
CCW | 7 | 45 | -315.00 | -135.00 | 50 | -0.27990004 | 0.50959984 | 25.64 | 0.058237 | -0.001765 | -0.26420010 | 0.51524980 | 25.62 | 0.034114 | -0.007874
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
