spaceleagueofjustice/MEMS_Earth_Rotation_Measurement/Project_Jaroslav/Measurement data/T16/T16-1/T16-1_mereni_summary.csv

smer | azimut | n | xA_prumer | xC_prumer | diffx_prumer | yA_prumer | yC_prumer | diffy_prumer | tA_prumer | tC_prumer | difft_prumer | axA_prumer | axC_prumer | diffax_prumer | ayA_prumer | ayC_prumer | diffay_prumer
CCW | 0 | 12 | -0,28053334 | -0,27594168 | -0,00459167 | 0,50258744 | 0,49742492 | 0,00516251 | 25,90 | 25,89 | 0,01 | 0,05163941 | 0,03952860 | 0,01211080 | 0,00495158 | -0,01439474 | 0,01934631
CCW | 22,5 | 16 | -0,27604690 | -0,27446562 | -0,00158128 | 0,49888744 | 0,49384676 | 0,00504071 | 26,03 | 26,04 | -0,00 | 0,05622833 | 0,03585617 | 0,02037216 | 0,00173279 | -0,01129501 | 0,01302780
CCW | 45 | 20 | -0,27879500 | -0,27516502 | -0,00362998 | 0,50169500 | 0,49443500 | 0,00725999 | 25,99 | 25,98 | 0,01 | 0,05763183 | 0,03427197 | 0,02335986 | -0,00259082 | -0,00690405 | 0,00431323
CCW | 67,5 | 19 | -0,28024474 | -0,27636316 | -0,00388157 | 0,50275510 | 0,49613416 | 0,00662094 | 25,98 | 25,98 | -0,00 | 0,05783564 | 0,03474159 | 0,02309405 | -0,00716771 | -0,00232692 | -0,00484079
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
