spaceleagueofjustice/MEMS_Earth_Rotation_Measurement/Project_Jaroslav/Measurement data/T16/T16-2/T16-2_mereni_data.csv

smer | cyklus | cilovy_azimut | skutecne_natoceni | jump_deg | trim | xA | yA | tA | axA | ayA | xC | yC | tC | axC | ayC
CW | 1 | 112.5 | 112.50 | 112.50 | 50 | -0.40335004 | 0.58864990 | 26.03 | 0.059807 | -0.014360 | -0.39164990 | 0.56474996 | 26.10 | 0.034136 | 0.005093
CW | 2 | 135 | 135.00 | 22.50 | 50 | -0.37135000 | 0.55249996 | 26.10 | 0.054790 | -0.018296 | -0.36880020 | 0.53840030 | 26.13 | 0.039475 | 0.009255
CW | 3 | 180 | 180.00 | 45.00 | 50 | -0.34640000 | 0.51109980 | 26.21 | 0.045991 | -0.019739 | -0.34729984 | 0.52095010 | 26.24 | 0.051846 | 0.010422
CW | 4 | 337.5 | 337.50 | 157.50 | 50 | -0.33670000 | 0.50429992 | 26.20 | 0.045056 | 0.010730 | -0.31879994 | 0.49849996 | 26.28 | 0.052678 | -0.020159
CW | 5 | 0 | 360.00 | 22.50 | 50 | -0.32564998 | 0.47914992 | 26.26 | 0.051194 | 0.009854 | -0.31594996 | 0.47605000 | 26.28 | 0.048533 | -0.019993
CCW | 6 | 292.5 | 292.50 | -67.50 | 50 | -0.31575006 | 0.48034990 | 26.30 | 0.033442 | 0.004033 | -0.30299994 | 0.48285004 | 26.30 | 0.060708 | -0.014346
CCW | 7 | 157.5 | 157.50 | -135.00 | 50 | -0.30250000 | 0.47585000 | 26.30 | 0.047678 | -0.020393 | -0.31690004 | 0.47315000 | 26.30 | 0.044470 | 0.010493
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
