spaceleagueofjustice/MEMS_Earth_Rotation_Measurement/Project_Jaroslav/Measurement data/T16/T16-2/T16-2_mereni_summary.csv

smer | azimut | n | xA_prumer | xC_prumer | diffx_prumer | yA_prumer | yC_prumer | diffy_prumer | tA_prumer | tC_prumer | difft_prumer | axA_prumer | axC_prumer | diffax_prumer | ayA_prumer | ayC_prumer | diffay_prumer
CCW | 0 | 21 | -0,31785002 | -0,31597150 | -0,00187853 | 0,47794764 | 0,47728570 | 0,00066194 | 26,49 | 26,50 | -0,01 | 0,05018880 | 0,04253080 | 0,00765799 | 0,01022728 | -0,01894310 | 0,02917039
CCW | 22,5 | 20 | -0,31353004 | -0,31319000 | -0,00034001 | 0,47196740 | 0,46842240 | 0,00354499 | 26,57 | 26,55 | 0,02 | 0,05582605 | 0,03729175 | 0,01853430 | 0,00742822 | -0,01644068 | 0,02386890
CCW | 45 | 12 | -0,31971250 | -0,31449170 | -0,00522080 | 0,47834992 | 0,47827080 | 0,00007913 | 26,52 | 26,52 | -0,01 | 0,05970296 | 0,03349772 | 0,02620524 | 0,00303670 | -0,01162577 | 0,01466248
CCW | 67,5 | 13 | -0,31220382 | -0,31578464 | 0,00358081 | 0,48006536 | 0,47380770 | 0,00625765 | 26,48 | 26,48 | -0,00 | 0,06153415 | 0,03175086 | 0,02978329 | -0,00274545 | -0,00623404 | 0,00348858
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
