spaceleagueofjustice/MEMS_Earth_Rotation_Measurement/Project_Jaroslav/Measurement data/T16/T16-3/T16-3_evaluation.xlsx

Sheet: Main
Test ID | T16-3 | Azimuth-Dependence Test (Randomized 360° Step Scan) |  |  |  |  |  |  |  | Orientation
Mount azimuth |  |  | 90 | ° | Description/title: | Code: |  |  |  |  |  | N
Arm start azimuth |  |  | 90 | ° | - Test v různých místnostech - Rotace ramene CW/CCW - Náhodné azimuty pro celých 360° - Různý azimut měřicí sestavy - Různý azimut ramene při startu - Různý náklon měřicí sestavy - Oprava xA-xC na správný směr xC-xA - POZOR, POKUD JE STARTOVNÍ POZICE RAMENE JINÁ, NEŽ 0°(SEVER), AZIMUT V GRAFECH NENÍ AZIMUT. HODNOTY SE VZTAHUJÍ KE STARTOVNÍ POZICI RAMENE! | HORIZONTAL slepý test 360-kontrola accel-lepší csv-azimut parametr-fixed trim settle-s navratem do A-antibacklash-CW-CCW-I2Coprava-název testu-teplota-oprava2
Measuring plane deviation/slope azimuth |  |  | 0 | °/°
Location |  |  | living room
Theoretical earth rotation rate |  |  | 0.004178 | °/s
Latitude |  |  | 49 | °
Theoretical earth rotation rate at latitude cos(lat) |  |  | 0.002741 | °/s
Azimuth step |  |  | 22.5 | °
Azimuth step count |  |  | 16
Rotation direction |  |  | CC/CCW |  |  | min X | min Y | max X | max Y | | | | | 90° | ↗
Cycles |  |  | 480
Samples per position |  |  | 200
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
