spaceleagueofjustice/MEMS_Earth_Rotation_Measurement/Project_Jaroslav/Measurement data/T16/T16-3/T16-3_mereni_data.csv

smer | cyklus | cilovy_azimut | skutecne_natoceni | jump_deg | trim | xA | yA | tA | axA | ayA | xC | yC | tC | axC | ayC
CW | 1 | 0 | 0.00 | 0.00 | 50 | -0.35349992 | 0.54335020 | 25.30 | 0.053518 | 0.012849 | -0.36005000 | 0.54200024 | 25.30 | 0.042351 | -0.019958
CW | 2 | 112.5 | 112.50 | 112.50 | 50 | -0.35705004 | 0.54685016 | 25.30 | 0.061318 | -0.017075 | -0.36009990 | 0.54170036 | 25.30 | 0.035635 | 0.010081
CCW | 3 | 0 | 0.00 | -112.50 | 50 | -0.36095000 | 0.53880024 | 25.30 | 0.054465 | 0.012603 | -0.35784984 | 0.52865004 | 25.30 | 0.039832 | -0.020156
CCW | 4 | 292.5 | -67.50 | -67.50 | 50 | -0.36345020 | 0.53595020 | 25.30 | 0.037341 | 0.009988 | -0.35594984 | 0.53545020 | 25.25 | 0.061128 | -0.017280
CW | 5 | 315 | -45.00 | 22.50 | 50 | -0.36775008 | 0.53715016 | 25.30 | 0.041426 | 0.013276 | -0.35115000 | 0.53765020 | 25.25 | 0.054189 | -0.020579
CCW | 6 | 180 | -180.00 | -135.00 | 50 | -0.35919990 | 0.53485010 | 25.24 | 0.039031 | -0.020049 | -0.35604990 | 0.53945010 | 25.17 | 0.052688 | 0.013191
CW | 7 | 247.5 | -112.50 | 67.50 | 50 | -0.36239996 | 0.53615004 | 25.20 | 0.029475 | -0.002761 | -0.36264996 | 0.53875008 | 25.15 | 0.065273 | -0.004670
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
