spaceleagueofjustice/MEMS_Earth_Rotation_Measurement/Project_Jaroslav/Measurement data/T16/T16-3/T16-3_mereni_summary.csv

smer | azimut | n | xA_prumer | xC_prumer | diffx_prumer | yA_prumer | yC_prumer | diffy_prumer | tA_prumer | tC_prumer | difft_prumer | axA_prumer | axC_prumer | diffax_prumer | ayA_prumer | ayC_prumer | diffay_prumer
CCW | 0 | 19 | -0,37078680 | -0,37076580 | -0,00002104 | 0,55947364 | 0,54945260 | 0,01002103 | 24,88 | 24,88 | 0,00 | 0,05649286 | 0,04036840 | 0,01612446 | 0,01217182 | -0,01920590 | 0,03137772
CCW | 22,5 | 15 | -0,36419668 | -0,36536664 | 0,00116998 | 0,54459660 | 0,53708000 | 0,00751662 | 25,06 | 25,07 | -0,01 | 0,06091569 | 0,03407894 | 0,02683675 | 0,00774186 | -0,01515853 | 0,02290039
CCW | 45 | 15 | -0,36526664 | -0,37178004 | 0,00651339 | 0,55341680 | 0,54496670 | 0,00845009 | 24,93 | 24,95 | -0,02 | 0,06429118 | 0,03176074 | 0,03253044 | 0,00164681 | -0,00863021 | 0,01027702
CCW | 67,5 | 9 | -0,35905556 | -0,36747224 | 0,00841668 | 0,53693340 | 0,53531664 | 0,00161678 | 25,15 | 25,12 | 0,02 | 0,06510091 | 0,02976318 | 0,03533772 | -0,00526123 | -0,00207655 | -0,00318468
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
