spaceleagueofjustice/MEMS_Earth_Rotation_Measurement/Project_Jaroslav/Measurement data/T16/T16-4/T16-4_mereni_data.csv

smer | cyklus | cilovy_azimut | skutecne_natoceni | jump_deg | trim | xA | yA | tA | axA | ayA | xC | yC | tC | axC | ayC
CW | 1 | 135 | 135.00 | 135.00 | 50 | -0.24874992 | 0.38039988 | 27.90 | 0.219985 | 0.167502 | -0.26555002 | 0.36544992 | 27.90 | -0.136479 | -0.179004
CW | 2 | 270 | 270.00 | 135.00 | 50 | -0.25339996 | 0.36624996 | 27.85 | 0.037329 | -0.254834 | -0.25840004 | 0.38635000 | 27.84 | 0.045671 | 0.243689
CCW | 3 | 90 | 90.00 | -180.00 | 50 | -0.25840014 | 0.38074972 | 27.84 | 0.045933 | 0.243086 | -0.26330004 | 0.35675008 | 27.81 | 0.037524 | -0.254482
CW | 4 | 90 | 90.00 | 0.00 | 50 | -0.24704998 | 0.37514984 | 27.82 | 0.044421 | 0.242832 | -0.26115010 | 0.36955000 | 27.87 | 0.038145 | -0.254900
CW | 5 | 180 | 180.00 | 90.00 | 50 | -0.26020000 | 0.37265000 | 27.80 | 0.289897 | -0.009502 | -0.26135010 | 0.37030004 | 27.75 | -0.206072 | -0.001814
CCW | 6 | 0 | 0.00 | -180.00 | 50 | -0.26714996 | 0.38329984 | 27.75 | -0.207349 | -0.002002 | -0.24630000 | 0.38059984 | 27.76 | 0.290413 | -0.008730
CW | 7 | 112.5 | 112.50 | 112.50 | 50 | -0.26280004 | 0.39365004 | 27.71 | 0.142957 | 0.222988 | -0.27199992 | 0.36959992 | 27.70 | -0.057815 | -0.234434
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
