spaceleagueofjustice/MEMS_Earth_Rotation_Measurement/Project_Jaroslav/Measurement data/T16/T16-4/T16-4_mereni_summary.csv

smer | azimut | n | xA_prumer | xC_prumer | diffx_prumer | yA_prumer | yC_prumer | diffy_prumer | tA_prumer | tC_prumer | difft_prumer | axA_prumer | axC_prumer | diffax_prumer | ayA_prumer | ayC_prumer | diffay_prumer
CCW | 0 | 13 | -0,27384228 | -0,25943846 | -0,01440382 | 0,39486544 | 0,39791160 | -0,00304613 | 27,45 | 27,45 | 0,00 | -0,20532490 | 0,29011304 | -0,49543792 | 0,00189340 | -0,01189322 | 0,01378662
CCW | 22,5 | 14 | -0,26951430 | -0,26029644 | -0,00921786 | 0,39801790 | 0,39455360 | 0,00346431 | 27,47 | 27,45 | 0,01 | -0,18278670 | 0,26763064 | -0,45041732 | 0,09740828 | -0,10711688 | 0,20452516
CCW | 45 | 17 | -0,27099412 | -0,25841176 | -0,01258236 | 0,40239124 | 0,39522652 | 0,00716472 | 27,41 | 27,41 | -0,00 | -0,12747542 | 0,21252600 | -0,34000140 | 0,17549546 | -0,18583668 | 0,36133212
CCW | 67,5 | 9 | -0,27154446 | -0,26410556 | -0,00743890 | 0,41095564 | 0,39335560 | 0,01760006 | 27,41 | 27,42 | -0,01 | -0,04494141 | 0,13131374 | -0,17625516 | 0,22667860 | -0,23672470 | 0,46340328
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
