spaceleagueofjustice/MEMS_Earth_Rotation_Measurement/Project_Jaroslav/Measurement data/T16/T16-5/T16-5_evaluation.xlsx

Sheet: Main
Test ID | T16-5 | Azimuth-Dependence Test (Randomized 360° Step Scan) |  |  |  |  |  |  |  |  | Orientation
Mount azimuth |  |  | 0 | ° | Description/title: | Code: |  |  |  |  |  |  | N
Arm start azimuth |  |  | 0 | ° | - Test v různých místnostech - Rotace ramene CW/CCW - Náhodné azimuty pro celých 360° - Různý azimut měřicí sestavy - Různý azimut ramene při startu - Různý náklon měřicí sestavy - Magnetické pole - Oprava xA-xC na správný směr xC-xA | HORIZONTAL slepý test 360-kontrola accel-lepší csv-azimut parametr-fixed trim settle-s navratem do A-antibacklash-CW-CCW-I2Coprava-název testu-teplota-oprava2
Measuring plane deviation/slope azimuth |  |  | 0 | °/°
Location |  |  | living room
Theoretical earth rotation rate |  |  | 0.004178 | °/s
Latitude |  |  | 49 | °
Theoretical earth rotation rate at latitude cos(lat) |  |  | 0.002741 | °/s |  |  |  |  |  | Background from stepper | | |  | ↗
Azimuth step |  |  | 22.5 | °
Azimuth step count |  |  | 16
Rotation direction |  |  | CC/CCW |  |  | min X | min Y | max X | max Y | 350 μT | | |  | 0° |  | | | ← | 2800 μT
Cycles |  |  | 480
Samples per position |  |  | 200
Trim |  |  | 50
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
