spaceleagueofjustice/MEMS_Earth_Rotation_Measurement/Project_Jaroslav/Measurement data/T16/T16-5/T16-5_mereni_data.csv

smer | cyklus | cilovy_azimut | skutecne_natoceni | jump_deg | trim | xA | yA | tA | axA | ayA | xC | yC | tC | axC | ayC
CW | 1 | 90 | 90.00 | 90.00 | 50 | -0.41595010 | 0.57015000 | 26.31 | 0.060879 | -0.014575 | -0.40825024 | 0.54769990 | 26.44 | 0.033623 | 0.004905
CW | 2 | 202.5 | 202.50 | 112.50 | 50 | -0.36995004 | 0.52700000 | 26.53 | 0.031638 | -0.014548 | -0.37440004 | 0.51424976 | 26.47 | 0.059983 | 0.005247
CCW | 3 | 90 | 90.00 | -112.50 | 50 | -0.36249996 | 0.50219992 | 26.54 | 0.062776 | -0.014331 | -0.35359992 | 0.48284984 | 26.51 | 0.029233 | 0.004841
CW | 4 | 135 | 135.00 | 45.00 | 50 | -0.32465010 | 0.48479996 | 26.59 | 0.050403 | -0.021882 | -0.33420002 | 0.46594992 | 26.54 | 0.042332 | 0.012388
CW | 5 | 225 | 225.00 | 90.00 | 50 | -0.33594992 | 0.46690004 | 26.56 | 0.029595 | -0.008030 | -0.33185002 | 0.46200004 | 26.60 | 0.061951 | -0.001040
CW | 6 | 337.5 | 337.50 | 112.50 | 50 | -0.31760000 | 0.46300004 | 26.60 | 0.049011 | 0.012844 | -0.32445014 | 0.46380000 | 26.60 | 0.043203 | -0.021716
CW | 7 | 0 | 360.00 | 22.50 | 50 | -0.32110010 | 0.47084990 | 26.60 | 0.056833 | 0.009810 | -0.30654996 | 0.45435000 | 26.60 | 0.039529 | -0.019353
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
