spaceleagueofjustice/MEMS_Earth_Rotation_Measurement/Project_Jaroslav/Measurement data/T16/T16-5/T16-5_mereni_summary.csv

smer | azimut | n | xA_prumer | xC_prumer | diffx_prumer | yA_prumer | yC_prumer | diffy_prumer | tA_prumer | tC_prumer | difft_prumer | axA_prumer | axC_prumer | diffax_prumer | ayA_prumer | ayC_prumer | diffay_prumer
CCW | 0 | 19 | -0,29721320 | -0,28936584 | -0,00784737 | 0,42725268 | 0,42834210 | -0,00108942 | 27,07 | 27,08 | -0,01 | 0,05440198 | 0,03545551 | 0,01894647 | 0,00854634 | -0,01892116 | 0,02746749
CCW | 22,5 | 11 | -0,29194546 | -0,28702270 | -0,00492275 | 0,42290460 | 0,42268640 | 0,00021821 | 27,12 | 27,13 | -0,01 | 0,05852983 | 0,02937900 | 0,02915083 | 0,00327415 | -0,01375399 | 0,01702814
CCW | 45 | 15 | -0,29107336 | -0,28985664 | -0,00121671 | 0,42938004 | 0,42241008 | 0,00696996 | 27,08 | 27,09 | -0,01 | 0,06143196 | 0,02760091 | 0,03383105 | -0,00290755 | -0,00750407 | 0,00459652
CCW | 67,5 | 14 | -0,30108570 | -0,30041072 | -0,00067499 | 0,44597856 | 0,43892500 | 0,00705355 | 26,93 | 26,92 | 0,01 | 0,06122106 | 0,02799020 | 0,03323086 | -0,00892439 | -0,00105922 | -0,00786516
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
