spaceleagueofjustice/MEMS_Earth_Rotation_Measurement/Project_Jaroslav/Measurement data/T16/T16-6/T16-6_mereni_data.csv

smer | cyklus | cilovy_azimut | skutecne_natoceni | jump_deg | trim | xA | yA | tA | axA | ayA | xC | yC | tC | axC | ayC
CCW | 1 | 315 | -45.00 | -45.00 | 50 | -0.50445010 | 0.77879984 | 22.88 | 0.169792 | -0.128523 | -0.50124990 | 0.75450016 | 22.94 | -0.078457 | 0.124016
CCW | 2 | 135 | -225.00 | -180.00 | 50 | -0.47664988 | 0.73535024 | 23.00 | -0.069656 | 0.123933 | -0.46915000 | 0.71730008 | 23.00 | 0.165334 | -0.128823
CCW | 3 | 45 | -315.00 | -90.00 | 50 | -0.45945000 | 0.69695016 | 23.03 | -0.076621 | -0.126580 | -0.43804990 | 0.68955000 | 23.08 | 0.175327 | 0.121450
CW | 4 | 67.5 | -292.50 | 22.50 | 50 | -0.44734992 | 0.67205000 | 23.11 | -0.115469 | -0.069216 | -0.42415000 | 0.68305016 | 23.08 | 0.212312 | 0.062808
CCW | 5 | 315 | -45.00 | -45.00 | 50 | -0.43339992 | 0.66625004 | 23.10 | 0.173125 | -0.128777 | -0.43405016 | 0.67800030 | 23.13 | -0.074153 | 0.123203
CCW | 6 | 247.5 | -112.50 | -67.50 | 50 | -0.41819990 | 0.65845000 | 23.16 | 0.212395 | 0.062566 | -0.42860004 | 0.67210000 | 23.13 | -0.116260 | -0.068711
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
