spaceleagueofjustice/MEMS_Earth_Rotation_Measurement/Project_Jaroslav/Measurement data/T16/T16-6/T16-6_mereni_summary.csv

smer | azimut | n | xA_prumer | xC_prumer | diffx_prumer | yA_prumer | yC_prumer | diffy_prumer | tA_prumer | tC_prumer | difft_prumer | axA_prumer | axC_prumer | diffax_prumer | ayA_prumer | ayC_prumer | diffay_prumer
CCW | 0 | 11 | -0,38232736 | -0,38500004 | 0,00267270 | 0,59403180 | 0,60606820 | -0,01203638 | 24,34 | 24,34 | 0,00 | 0,04616788 | 0,04532959 | 0,00083829 | -0,18119806 | 0,17373090 | -0,35492896
CCW | 22,5 | 17 | -0,38137650 | -0,37658236 | -0,00479415 | 0,57746756 | 0,58157352 | -0,00410599 | 24,62 | 24,63 | -0,01 | -0,01806095 | 0,11123836 | -0,12929932 | -0,16896412 | 0,16134778 | -0,33031190
CCW | 45 | 18 | -0,38773610 | -0,38268616 | -0,00504997 | 0,59120840 | 0,59054724 | 0,00066113 | 24,47 | 24,48 | -0,00 | -0,07743260 | 0,17069552 | -0,24812812 | -0,13065160 | 0,12370090 | -0,25435248
CCW | 67,5 | 14 | -0,38794648 | -0,38017500 | -0,00777143 | 0,59455360 | 0,59064280 | 0,00391078 | 24,42 | 24,41 | 0,01 | -0,11601894 | 0,21033188 | -0,32635080 | -0,07320086 | 0,06574550 | -0,13894636
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
