spaceleagueofjustice/MEMS_Earth_Rotation_Measurement/Project_Jaroslav/Measurement data/T17/T17-1/T17-1_evaluation.xlsx

Sheet: Main
Test ID | T17-1 | Extended azimuth/tilt-Dependence Test (Randomized 360° Step Scan) |  |  |  |  |  |  |  | Orientation
Mount azimuth |  |  | 0 | ° | Description/title: | Code: |  |  |  |  |  | N
Arm start azimuth |  |  | 0 | ° | - Rotace ramene CW/CCW - Náhodné azimuty pro celých 360° - 4x různý azimut sestavy (0°-90°-180°-270°) - Azimut ramene při startu vžy 0° (sever) - Kalibrace do nulového náklony do 0,5° (přibližně) - Vyměněné měřicí rameno - TEST MÁ VYVRÁTIT/POTVRDIT MOŽNOST, ŽE FÁZE SIGNÁLU JE GENEROVANÁ I MINIMÁLNÍM NÁKLONEM SESTAVY - Oprava xA-xC na správný směr xC-xA | HORIZONTAL slepý test 360-kontrola accel-lepší csv-azimut parametr-fixed trim settle-s navratem do A-antibacklash-CW-CCW-I2Coprava-název testu-teplota-oprava2
Measuring plane deviation/slope azimuth |  |  | 0 | °/°
Location |  |  | living room
Theoretical earth rotation rate |  |  | 0.004178 | °/s
Latitude |  |  | 49 | °
Theoretical earth rotation rate at latitude cos(lat) |  |  | 0.002741 | °/s |  |  |  |  |  | | |  | ↗
Azimuth step |  |  | 22.5 | °
Azimuth step count |  |  | 16
Rotation direction |  |  | CC/CCW |  |  | min X | min Y | max X | max Y | | |  | 0°
Cycles |  |  | 150
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
