spaceleagueofjustice/MEMS_Earth_Rotation_Measurement/Project_Jaroslav/Measurement data/T17/T17-1/T17-1_mereni_data.csv

smer | cyklus | cilovy_azimut | skutecne_natoceni | jump_deg | trim | xA | yA | tA | axA | ayA | xC | yC | tC | axC | ayC
CW | 1 | 67.5 | 67.50 | 67.50 | 50 | -0.42654992 | 0.86830000 | 25.94 | 0.047966 | -0.012639 | -0.42599990 | 0.84164970 | 25.98 | 0.031443 | 0.018645
CCW | 2 | 292.5 | -67.50 | -135.00 | 50 | -0.42094990 | 0.83619990 | 25.96 | 0.043464 | 0.020649 | -0.40240004 | 0.83240020 | 25.91 | 0.034617 | -0.014429
CW | 3 | 45 | 45.00 | 112.50 | 50 | -0.39175000 | 0.80310010 | 25.97 | 0.052417 | -0.008667 | -0.39380004 | 0.78829976 | 25.96 | 0.022598 | 0.014045
CW | 4 | 157.5 | 157.50 | 112.50 | 50 | -0.39164996 | 0.79384992 | 26.07 | 0.023667 | -0.005920 | -0.38779992 | 0.79469980 | 26.06 | 0.053484 | 0.012097
CCW | 5 | 0 | 0.00 | -157.50 | 50 | -0.39870008 | 0.77449984 | 26.02 | 0.054458 | 0.005435 | -0.38190010 | 0.76819990 | 26.10 | 0.023538 | 0.001655
CW | 6 | 67.5 | 67.50 | 67.50 | 50 | -0.39089990 | 0.77594980 | 26.10 | 0.048296 | -0.012876 | -0.38554980 | 0.77339984 | 26.06 | 0.031528 | 0.018860
CW | 7 | 157.5 | 157.50 | 90.00 | 50 | -0.37225016 | 0.76060000 | 26.10 | 0.022371 | -0.005452 | -0.39034990 | 0.76110000 | 26.10 | 0.053887 | 0.012097
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
