spaceleagueofjustice/MEMS_Earth_Rotation_Measurement/Project_Jaroslav/Measurement data/T17/T17-1/T17-1_mereni_summary.csv

smer | azimut | n | xA_prumer | xC_prumer | diffx_prumer | yA_prumer | yC_prumer | diffy_prumer | tA_prumer | tC_prumer | difft_prumer | axA_prumer | axC_prumer | diffax_prumer | ayA_prumer | ayC_prumer | diffay_prumer
CCW | 0 | 7 | -0,39617152 | -0,38543572 | -0,01073581 | 0,6880428 | 0,6874213 | 0,00062144 | 26,17 | 26,19 | -0,02 | 0,05569824 | 0,02066022 | 0,03503802 | 0,00492467 | 0,00169294 | 0,00323172
CCW | 22,5 | 6 | -0,3889 | -0,38335 | -0,00555003 | 0,66313324 | 0,65864176 | 0,00449151 | 26,19 | 26,2 | -0,02 | 0,05543661 | 0,02204997 | 0,03338664 | -0,00200277 | 0,00868571 | -0,01068848
CCW | 45 | 5 | -0,38319008 | -0,38107004 | -0,00212002 | 0,68807008 | 0,6837401 | 0,00432998 | 26,15 | 26,18 | -0,02 | 0,05296338 | 0,02577881 | 0,02718457 | -0,00846094 | 0,01473438 | -0,02319531
CCW | 67,5 | 4 | -0,38859996 | -0,39143748 | 0,00283751 | 0,65092504 | 0,64562492 | 0,0053001 | 26,16 | 26,17 | 0 | 0,04679016 | 0,03059143 | 0,01619873 | -0,01264343 | 0,01956482 | -0,03220825
CCW | 90 | 1 | -0,4085 | -0,40280016 | -0,00569987 | 0,5942499 | 0,58909992 | 0,00514996 | 26,26 | 26,3 | -0,04 | 0,03996338 | 0,03564453 | 0,00431885 | -0,01315674 | 0,02139404 | -0,03455078
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
