spaceleagueofjustice/MEMS_Earth_Rotation_Measurement/Project_Jaroslav/Measurement data/T17/T17-2/T17-2_mereni_data.csv

smer | cyklus | cilovy_azimut | skutecne_natoceni | jump_deg | trim | xA | yA | tA | axA | ayA | xC | yC | tC | axC | ayC
CCW | 1 | 337.5 | -22.50 | -22.50 | 50 | -0.40440010 | 0.55105008 | 26.59 | 0.029150 | 0.008359 | -0.39554992 | 0.55620010 | 26.57 | 0.045859 | -0.001653
CW | 2 | 112.5 | 112.50 | 135.00 | 50 | -0.40490012 | 0.55065000 | 26.60 | 0.047092 | 0.005742 | -0.39400016 | 0.55344984 | 26.58 | 0.029753 | 0.001143
CW | 3 | 247.5 | 247.50 | 135.00 | 50 | -0.39390000 | 0.54260004 | 26.60 | 0.034231 | -0.004854 | -0.40920012 | 0.56020010 | 26.60 | 0.042134 | 0.011133
CW | 4 | 0 | 360.00 | 112.50 | 50 | -0.40295004 | 0.55045010 | 26.59 | 0.031106 | 0.011296 | -0.40550010 | 0.54460008 | 26.60 | 0.043306 | -0.003628
CW | 5 | 135 | 135.00 | 135.00 | 50 | -0.39559990 | 0.54725010 | 26.60 | 0.047346 | 0.001157 | -0.40565004 | 0.54635000 | 26.60 | 0.027881 | 0.005081
CW | 6 | 292.5 | 292.50 | 157.50 | 50 | -0.40630010 | 0.53805020 | 26.59 | 0.029519 | 0.000898 | -0.40045000 | 0.55840010 | 26.60 | 0.046211 | 0.005745
CW | 7 | 90 | 90.00 | 90.00 | 50 | -0.40655004 | 0.55560000 | 26.60 | 0.045393 | 0.008621 | -0.41185010 | 0.55230010 | 26.58 | 0.030332 | -0.002659
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
