spaceleagueofjustice/MEMS_Earth_Rotation_Measurement/Project_Jaroslav/Measurement data/T17/T17-2/T17-2_mereni_summary.csv

smer | azimut | n | xA_prumer | xC_prumer | diffx_prumer | yA_prumer | yC_prumer | diffy_prumer | tA_prumer | tC_prumer | difft_prumer | axA_prumer | axC_prumer | diffax_prumer | ayA_prumer | ayC_prumer | diffay_prumer
CCW | 0 | 6 | -0,41896664 | -0,41015004 | -0,00881660 | 0,59673332 | 0,59596676 | 0,00076658 | 25,43 | 25,43 | 0,01 | 0,03320842 | 0,04385132 | -0,01064290 | 0,01207642 | -0,00345174 | 0,01552816
CCW | 22,5 | 7 | -0,42832140 | -0,41798564 | -0,01033577 | 0,62214284 | 0,61957140 | 0,00257146 | 24,89 | 24,88 | 0,00 | 0,03776088 | 0,04158691 | -0,00382603 | 0,01373744 | -0,00428885 | 0,01802630
CCW | 45 | 7 | -0,41277144 | -0,40982872 | -0,00294271 | 0,57977870 | 0,57225716 | 0,00752151 | 25,83 | 25,81 | 0,02 | 0,03995047 | 0,03664377 | 0,00330671 | 0,01282645 | -0,00503069 | 0,01785714
CCW | 67,5 | 5 | -0,42292992 | -0,42144000 | -0,00148997 | 0,62367004 | 0,61492010 | 0,00874996 | 24,89 | 24,89 | 0,00 | 0,04424756 | 0,03529150 | 0,00895606 | 0,01230762 | -0,00303369 | 0,01534131
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
