spaceleagueofjustice/MEMS_Earth_Rotation_Measurement/Project_Jaroslav/Measurement data/T17/T17-3/T17-3_mereni_data.csv

smer | cyklus | cilovy_azimut | skutecne_natoceni | jump_deg | trim | xA | yA | tA | axA | ayA | xC | yC | tC | axC | ayC
CCW | 1 | 292.5 | -67.50 | -67.50 | 50 | -0.41230010 | 0.63865008 | 23.95 | 0.036521 | 0.000815 | -0.42740000 | 0.65035004 | 23.98 | 0.043284 | 0.010208
CW | 2 | 45 | 45.00 | 112.50 | 50 | -0.43530004 | 0.65439990 | 23.93 | 0.038430 | 0.009741 | -0.43174984 | 0.65294980 | 23.95 | 0.045198 | 0.000112
CW | 3 | 202.5 | 202.50 | 157.50 | 50 | -0.44039984 | 0.64779984 | 23.82 | 0.046421 | 0.002471 | -0.43034992 | 0.65269970 | 23.86 | 0.036211 | 0.007852
CW | 4 | 0 | 360.00 | 157.50 | 50 | -0.43934996 | 0.66660000 | 23.80 | 0.038359 | 0.006008 | -0.43325004 | 0.65825004 | 23.80 | 0.047188 | 0.004807
CCW | 5 | 315 | 315.00 | -45.00 | 50 | -0.43350000 | 0.65124992 | 23.80 | 0.037690 | 0.002849 | -0.42795000 | 0.66164992 | 23.79 | 0.046697 | 0.009216
CCW | 6 | 225 | 225.00 | -90.00 | 50 | -0.43625010 | 0.65004990 | 23.80 | 0.044812 | 0.000813 | -0.44140010 | 0.66075004 | 23.80 | 0.038892 | 0.010776
CCW | 7 | 135 | 135.00 | -90.00 | 50 | -0.43434992 | 0.66204992 | 23.80 | 0.046526 | 0.009241 | -0.44319996 | 0.65804980 | 23.79 | 0.038271 | 0.002563
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
