spaceleagueofjustice/MEMS_Earth_Rotation_Measurement/Project_Jaroslav/Measurement data/T17/T17-3/T17-3_mereni_summary.csv

smer | azimut | n | xA_prumer | xC_prumer | diffx_prumer | yA_prumer | yC_prumer | diffy_prumer | tA_prumer | tC_prumer | difft_prumer | axA_prumer | axC_prumer | diffax_prumer | ayA_prumer | ayC_prumer | diffay_prumer
CCW | 0 | 4 | -0,43081252 | -0,43476252 | 0,00395000 | 0,66126240 | 0,66324996 | -0,00198758 | 23,62 | 23,60 | 0,02 | 0,03567505 | 0,04707764 | -0,01140259 | 0,00655823 | 0,00511169 | 0,00144653
CCW | 22,5 | 7 | -0,43325712 | -0,42993576 | -0,00332138 | 0,65917140 | 0,66903580 | -0,00986439 | 23,65 | 23,65 | 0,00 | 0,03571673 | 0,04645054 | -0,01073381 | 0,00919399 | 0,00273054 | 0,00646345
CCW | 45 | 4 | -0,43247492 | -0,43032496 | -0,00214997 | 0,66177500 | 0,66225000 | -0,00047499 | 23,64 | 23,65 | -0,01 | 0,03847962 | 0,04530212 | -0,00682251 | 0,01037781 | 0,00063477 | 0,00974304
CCW | 67,5 | 3 | -0,43309996 | -0,42681670 | -0,00628325 | 0,67186664 | 0,66570000 | 0,00616664 | 23,54 | 23,52 | 0,02 | 0,03979737 | 0,04376953 | -0,00397216 | 0,01135091 | -0,00040934 | 0,01176025
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
