spaceleagueofjustice/MEMS_Earth_Rotation_Measurement/Project_Jaroslav/Measurement data/T17/T17-4/T17-4_mereni_data.csv

smer | cyklus | cilovy_azimut | skutecne_natoceni | jump_deg | trim | xA | yA | tA | axA | ayA | xC | yC | tC | axC | ayC
CCW | 1 | 247.5 | -112.50 | -112.50 | 50 | -0.41504996 | 0.63025000 | 23.90 | 0.057871 | 0.010432 | -0.41899992 | 0.62709980 | 23.93 | 0.024702 | 0.001052
CCW | 2 | 180 | -180.00 | -67.50 | 50 | -0.41610008 | 0.63650000 | 23.97 | 0.043298 | 0.022649 | -0.41595000 | 0.64474980 | 23.99 | 0.039827 | -0.012395
CCW | 3 | 90 | -270.00 | -90.00 | 50 | -0.42205012 | 0.64914980 | 23.93 | 0.024580 | 0.007461 | -0.42384996 | 0.64064984 | 23.97 | 0.058303 | 0.003091
CW | 4 | 225 | -135.00 | 135.00 | 50 | -0.42514992 | 0.63265016 | 23.99 | 0.054600 | 0.016641 | -0.42569990 | 0.64119990 | 23.99 | 0.028093 | -0.006162
CW | 5 | 247.5 | -112.50 | 22.50 | 50 | -0.41535004 | 0.64715000 | 24.00 | 0.057524 | 0.010752 | -0.42630004 | 0.63499992 | 24.00 | 0.024580 | 0.000249
CCW | 6 | 135 | -225.00 | -112.50 | 50 | -0.42179992 | 0.64289990 | 24.00 | 0.030925 | 0.018953 | -0.41995000 | 0.63064990 | 24.01 | 0.052861 | -0.007732
CCW | 7 | 67.5 | -292.50 | -67.50 | 50 | -0.42419996 | 0.64250000 | 24.00 | 0.024639 | 0.000969 | -0.42404980 | 0.63540000 | 24.00 | 0.058208 | 0.011106
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
