spaceleagueofjustice/MEMS_Earth_Rotation_Measurement/Project_Jaroslav/Measurement data/T17/T17-4/T17-4_mereni_summary.csv

smer | azimut | n | xA_prumer | xC_prumer | diffx_prumer | yA_prumer | yC_prumer | diffy_prumer | tA_prumer | tC_prumer | difft_prumer | axA_prumer | axC_prumer | diffax_prumer | ayA_prumer | ayC_prumer | diffay_prumer
CCW | 0 | 6 | -0,42506660 | -0,42424164 | -0,00082499 | 0,67320010 | 0,67715000 | -0,00394994 | 23,41 | 23,38 | 0,03 | 0,03926798 | 0,04295858 | -0,00369059 | -0,01184204 | 0,02365031 | -0,03549235
CCW | 22,5 | 3 | -0,42528332 | -0,42098332 | -0,00430000 | 0,67101664 | 0,67308330 | -0,00206667 | 23,38 | 23,37 | 0,01 | 0,03313070 | 0,05057861 | -0,01744792 | -0,01006592 | 0,02118083 | -0,03124675
CCW | 45 | 4 | -0,42936240 | -0,42973748 | 0,00037506 | 0,66131260 | 0,65458740 | 0,00672519 | 23,70 | 23,67 | 0,03 | 0,02739929 | 0,05495850 | -0,02755921 | -0,00564819 | 0,01666931 | -0,02231750
CCW | 67,5 | 6 | -0,42870830 | -0,42201660 | -0,00669169 | 0,66478324 | 0,65968340 | 0,00509983 | 23,63 | 23,59 | 0,03 | 0,02469645 | 0,05792358 | -0,03322713 | 0,00049398 | 0,01150635 | -0,01101237
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
