spaceleagueofjustice/MEMS_Earth_Rotation_Measurement/Project_Jaroslav/Measurement data/T18/T18-1/T18-1_evaluation.xlsx

Sheet: Main
Test ID | T18-1 | Extended azimuth Dependence Test (Randomized 360° Step Scan) bambilion points |  |  |  |  |  |  |  | Orientation
Mount azimuth |  |  | 0 | ° | Description/title: | Code: |  |  |  |  |  | N
Arm start azimuth |  |  | 0 | ° | - Rotace ramene CW/CCW - Náhodné azimuty pro celých 360° - 4x různý azimut sestavy (0°-90°-180°-270°) - Azimut ramene při startu vžy 0° (sever) - Kalibrace nulového náklonu do 0,5° (přibližně) - Vyměněné měřicí rameno - Oprava xA-xC na správný směr xC-xA | dlouhodobý test 360.py
Measuring plane deviation/slope azimuth |  |  | 0 | °/°
Location |  |  | living room
Theoretical earth rotation rate |  |  | 0.004178 | °/s
Latitude |  |  | 49 | °
Theoretical earth rotation rate at latitude cos(lat) |  |  | 0.002741 | °/s |  |  |  |  |  | | |  | ↗
Azimuth step |  |  | 5 | °
Azimuth step count |  |  | 72
Rotation direction |  |  | CC/CCW |  |  | min X | min Y | max X | max Y | | |  | 0°
Cycles |  |  | 1440
Samples per position |  |  | 200
Trim |  |  | 50
Cable protection |  |  | 400 | ° |  | -0.000176 | 0.000008 | 0.003360 | 0.003367
Total samples |  |  | 576000
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
