spaceleagueofjustice/MEMS_Earth_Rotation_Measurement/Project_Jaroslav/Measurement data/T18/T18-1/T18-1_mereni_data.csv

smer | cyklus | cilovy_azimut | skutecne_natoceni | jump_deg | trim | xA | yA | tA | axA | ayA | xC | yC | tC | axC | ayC
CCW | 1 | 185 | -175.00 | -175.00 | 50 | -0.48755016 | 0.71490016 | 24.68 | 0.030417 | 0.001145 | -0.47760010 | 0.68620010 | 24.68 | 0.043127 | 0.007449
CCW | 2 | 80 | -280.00 | -105.00 | 50 | -0.45464990 | 0.67074996 | 24.72 | 0.046614 | -0.000757 | -0.45374992 | 0.64220010 | 24.80 | 0.034888 | 0.010161
CW | 3 | 90 | -270.00 | 10.00 | 50 | -0.43630000 | 0.62684992 | 24.80 | 0.041113 | -0.000735 | -0.43755000 | 0.60575016 | 24.80 | 0.033940 | 0.010549
CW | 4 | 165 | -195.00 | 75.00 | 50 | -0.40795004 | 0.59929980 | 24.88 | 0.033049 | -0.000601 | -0.41635000 | 0.58294992 | 24.91 | 0.041887 | 0.010281
CW | 5 | 235 | -125.00 | 70.00 | 50 | -0.40080016 | 0.57400000 | 24.99 | 0.031055 | 0.007261 | -0.39895004 | 0.57485020 | 24.99 | 0.043901 | 0.001741
CW | 6 | 245 | -115.00 | 10.00 | 50 | -0.41465004 | 0.55289996 | 24.97 | 0.032476 | 0.007871 | -0.40270000 | 0.56365000 | 24.97 | 0.044595 | 0.000349
CCW | 7 | 205 | -155.00 | -40.00 | 50 | -0.39550000 | 0.55235020 | 24.98 | 0.031489 | 0.003757 | -0.38634992 | 0.54655004 | 24.98 | 0.044490 | 0.005117
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
