spaceleagueofjustice/MEMS_Earth_Rotation_Measurement/Project_Jaroslav/Measurement data/T18/T18-1/T18-1_mereni_summary.csv

azimut | n | nCW | nCCW | xA_prumer | xC_prumer | diffx_prumer | yA_prumer | yC_prumer | diffy_prumer | tA_prumer | tC_prumer | difft_prumer | axA_prumer | axC_prumer | diffax_prumer | ayA_prumer | ayC_prumer | diffay_prumer
0 | 20 | 8 | 12 | -0,43463248 | -0,43284256 | -0,00178993 | 0,55447750 | 0,55409000 | 0,00038749 | 25,12 | 25,12 | 0,00 | 0,04254736 | 0,03160205 | 0,01094532 | 0,00849561 | 0,00170007 | 0,00679553
5 | 20 | 11 | 9 | -0,43672252 | -0,43263250 | -0,00409001 | 0,55638752 | 0,55182756 | 0,00455999 | 25,14 | 25,14 | -0,00 | 0,04280578 | 0,03109118 | 0,01171460 | 0,00813135 | 0,00215161 | 0,00597974
10 | 20 | 10 | 10 | -0,43700744 | -0,43160744 | -0,00540000 | 0,55060756 | 0,55059252 | 0,00001502 | 25,17 | 25,17 | -0,00 | 0,04282959 | 0,03158166 | 0,01124793 | 0,00770398 | 0,00250037 | 0,00520361
15 | 20 | 9 | 11 | -0,43508500 | -0,43270750 | -0,00237751 | 0,56117250 | 0,55588510 | 0,00528741 | 25,05 | 25,05 | -0,00 | 0,04349915 | 0,03159522 | 0,01190393 | 0,00716919 | 0,00304895 | 0,00412024
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
