spaceleagueofjustice/MEMS_Earth_Rotation_Measurement/Project_Jaroslav/Measurement data/T18/T18-2/T18-2_mereni_data.csv

smer | cyklus | cilovy_azimut | skutecne_natoceni | jump_deg | trim | xA | yA | tA | axA | ayA | xC | yC | tC | axC | ayC
CW | 1 | 55 | 55.00 | 55.00 | 50 | -0.42159990 | 0.68560000 | 23.30 | 0.045352 | 0.003792 | -0.42549996 | 0.66780030 | 23.30 | 0.032202 | 0.006255
CCW | 2 | 0 | 0.00 | -55.00 | 50 | -0.43910012 | 0.65899990 | 23.30 | 0.042483 | 0.010215 | -0.41899992 | 0.65699992 | 23.31 | 0.034539 | 0.000742
CW | 3 | 45 | 45.00 | 45.00 | 50 | -0.41460000 | 0.65514980 | 23.32 | 0.044302 | 0.005605 | -0.41565000 | 0.64619980 | 23.33 | 0.033020 | 0.006458
CW | 4 | 215 | 215.00 | 170.00 | 50 | -0.40900016 | 0.64164996 | 23.34 | 0.031885 | 0.004353 | -0.40200012 | 0.64489984 | 23.35 | 0.045759 | 0.006653
CW | 5 | 345 | 345.00 | 130.00 | 50 | -0.40930020 | 0.64065000 | 23.39 | 0.041079 | 0.011123 | -0.40935000 | 0.62445000 | 23.43 | 0.038376 | -0.000327
CW | 6 | 20 | 380.00 | 35.00 | 50 | -0.40675010 | 0.63369984 | 23.39 | 0.044260 | 0.008184 | -0.40015000 | 0.62640000 | 23.43 | 0.033335 | 0.002483
CW | 7 | 80 | 80.00 | 80.00 | 50 | -0.40305004 | 0.63965000 | 23.41 | 0.044270 | 0.001941 | -0.40690016 | 0.64299980 | 23.37 | 0.034241 | 0.009587
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
