spaceleagueofjustice/MEMS_Earth_Rotation_Measurement/Project_Jaroslav/Measurement data/T18/T18-2/T18-2_mereni_summary.csv

azimut | n | nCW | nCCW | xA_prumer | xC_prumer | diffx_prumer | yA_prumer | yC_prumer | diffy_prumer | tA_prumer | tC_prumer | difft_prumer | axA_prumer | axC_prumer | diffax_prumer | ayA_prumer | ayC_prumer | diffay_prumer
0 | 20 | 10 | 10 | -0,43194000 | -0,43022500 | -0,00171503 | 0,71304240 | 0,71089496 | 0,00214750 | 22,22 | 22,21 | 0,00 | 0,02757458 | 0,02235315 | 0,00522143 | 0,00694287 | 0,00116968 | 0,00577319
5 | 20 | 15 | 5 | -0,43030752 | -0,42603000 | -0,00427756 | 0,71526000 | 0,71203748 | 0,00322253 | 22,22 | 22,23 | -0,01 | 0,02866321 | 0,02340222 | 0,00526098 | 0,00693286 | 0,00137366 | 0,00555920
10 | 20 | 9 | 11 | -0,43091744 | -0,42767752 | -0,00323990 | 0,71420752 | 0,71019240 | 0,00401509 | 22,23 | 22,22 | 0,01 | 0,02813404 | 0,02195154 | 0,00618250 | 0,00625024 | 0,00170532 | 0,00454492
15 | 20 | 11 | 9 | -0,43099756 | -0,42545752 | -0,00554001 | 0,71661248 | 0,71166000 | 0,00495249 | 22,21 | 22,20 | 0,01 | 0,02803564 | 0,02182251 | 0,00621314 | 0,00608704 | 0,00188440 | 0,00420264
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
