spaceleagueofjustice/MEMS_Earth_Rotation_Measurement/Project_Jaroslav/Measurement data/T13/T13-1/T13-1_mereni_random_data.csv

cyklus | cilovy_azimut | skutecne_natoceni | jump_deg | trim | xA | yA | axA | ayA | xC | yC | axC | ayC
1 | 337.5 | -22.50 | -22.50 | 50 | -0.26059996 | 0.51624990 | 0.055886 | -0.022905 | -0.23405002 | 0.52009990 | 0.037317 | 0.008799
2 | 45 | 45.00 | 67.50 | 50 | -0.25500000 | 0.52900010 | 0.035283 | -0.021821 | -0.24520000 | 0.51819984 | 0.057505 | 0.007671
3 | 202.5 | -157.50 | -157.50 | 50 | -0.24940000 | 0.51189980 | 0.050315 | 0.010930 | -0.25550008 | 0.51519980 | 0.041538 | -0.024702
4 | 22.5 | 22.50 | 22.50 | 50 | -0.25585002 | 0.51814976 | 0.041523 | -0.024717 | -0.25430000 | 0.51650000 | 0.051250 | 0.010544
5 | 135 | 135.00 | 112.50 | 50 | -0.24965010 | 0.52954996 | 0.031877 | 0.003896 | -0.25150004 | 0.51239984 | 0.061355 | -0.017939
6 | 67.5 | 67.50 | -67.50 | 50 | -0.25925002 | 0.52269984 | 0.030369 | -0.016401 | -0.24849996 | 0.51564984 | 0.062200 | 0.002612
7 | 270 | -90.00 | -157.50 | 50 | -0.25114996 | 0.52635000 | 0.064316 | -0.003940 | -0.25160004 | 0.53210000 | 0.025498 | -0.009343
8 | 0 | 0.00 | 90.00 | 50 | -0.25950006 | 0.52729992 | 0.048140 | -0.025549 | -0.23869990 | 0.52244984 | 0.042202 | 0.011160
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
