spaceleagueofjustice/MEMS_Earth_Rotation_Measurement/Project_Jaroslav/Measurement data/T13/T13-1/T13-1_mereni_random_summary.csv

azimut | n | xA_prumer | xC_prumer | diffx_prumer | yA_prumer | yC_prumer | diffy_prumer | axA_prumer | axC_prumer | diffax_prumer | ayA_prumer | ayC_prumer | diffay_prumer
0 | 50 | -0,22268596 | -0,21684298 | -0,00584297 | 0,43940704 | 0,43662900 | 0,00277805 | 0,04646318 | 0,04198764 | 0,00447554 | -0,02639019 | 0,01129448 | -0,03768467
22,5 | 50 | -0,22348398 | -0,21734402 | -0,00613996 | 0,43838408 | 0,43286392 | 0,00552014 | 0,03898852 | 0,04930343 | -0,01031491 | -0,02585537 | 0,01070508 | -0,03656045
45 | 50 | -0,22519004 | -0,21763296 | -0,00755706 | 0,43981904 | 0,43291800 | 0,00690106 | 0,03237446 | 0,05613047 | -0,02375601 | -0,02251626 | 0,00748369 | -0,02999995
67,5 | 50 | -0,22325700 | -0,22112902 | -0,00212798 | 0,43976992 | 0,43375504 | 0,00601488 | 0,02765005 | 0,06085292 | -0,03320287 | -0,01691787 | 0,00190166 | -0,01881953
90 | 50 | -0,22024702 | -0,22183198 | 0,00158496 | 0,44153900 | 0,43297100 | 0,00856799 | 0,02547422 | 0,06385513 | -0,03838091 | -0,00987168 | -0,00500728 | -0,00486440
112,5 | 50 | -0,21940696 | -0,22267200 | 0,00326504 | 0,43994990 | 0,43426392 | 0,00568596 | 0,02595717 | 0,06286070 | -0,03690352 | -0,00231939 | -0,01242485 | 0,01010547
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
