spaceleagueofjustice/MEMS_Earth_Rotation_Measurement/Project_Jaroslav/Measurement data/T13/T13-2/T13-2_mereni_random_data.csv

cyklus | cilovy_azimut | skutecne_natoceni | jump_deg | trim | xA | yA | axA | ayA | xC | yC | axC | ayC
1 | 180 | -180.00 | -180.00 | 50 | -0.37405010 | 0.80810010 | 0.112698 | 0.017888 | -0.37255016 | 0.79099976 | -0.012610 | -0.028386
2 | 247.5 | -112.50 | -112.50 | 50 | -0.36730012 | 0.77519990 | 0.096091 | -0.054282 | -0.34124990 | 0.77100000 | 0.002969 | 0.044812
3 | 157.5 | 157.50 | 90.00 | 50 | -0.34319984 | 0.76380020 | 0.100969 | 0.040964 | -0.35524992 | 0.75490016 | 0.000908 | -0.050850
4 | 202.5 | 202.50 | -135.00 | 50 | -0.33634992 | 0.74795010 | 0.116833 | -0.007283 | -0.34434990 | 0.75900008 | -0.018169 | -0.002361
5 | 22.5 | 22.50 | 22.50 | 50 | -0.33684980 | 0.73329980 | -0.017971 | -0.002571 | -0.32310010 | 0.73309990 | 0.116995 | -0.007305
6 | 315 | 315.00 | 112.50 | 50 | -0.32650004 | 0.73480032 | 0.021851 | -0.066238 | -0.30840006 | 0.72265000 | 0.079548 | 0.056753
7 | 0 | 360.00 | -135.00 | 50 | -0.33729988 | 0.72774990 | -0.014661 | -0.028230 | -0.33030004 | 0.72354980 | 0.118047 | 0.017893
8 | 135 | 135.00 | 135.00 | 50 | -0.32660016 | 0.72979984 | 0.078682 | 0.056238 | -0.33270000 | 0.73029984 | 0.021641 | -0.066360
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
