spaceleagueofjustice/MEMS_Earth_Rotation_Measurement/Project_Jaroslav/Measurement data/T13/T13-2/T13-2_mereni_random_summary.csv

azimut | n | xA_prumer | xC_prumer | diffx_prumer | yA_prumer | yC_prumer | diffy_prumer | axA_prumer | axC_prumer | diffax_prumer | ayA_prumer | ayC_prumer | diffay_prumer
0 | 50 | -0,31368600 | -0,30515304 | -0,00853297 | 0,65795400 | 0,65736900 | 0,00058496 | -0,01536490 | 0,11705024 | -0,13241514 | -0,02673325 | 0,01569243 | -0,04242568
22,5 | 50 | -0,31210100 | -0,30650502 | -0,00559598 | 0,65517010 | 0,65485390 | 0,00031620 | -0,01870176 | 0,11596073 | -0,13466250 | -0,00058711 | -0,01026768 | 0,00968057
45 | 50 | -0,31180108 | -0,30544604 | -0,00635505 | 0,65919600 | 0,65266610 | 0,00652993 | -0,01184971 | 0,10886562 | -0,12071534 | 0,02486826 | -0,03561568 | 0,06048394
67,5 | 50 | -0,30938306 | -0,30818300 | -0,00120005 | 0,66032390 | 0,65226808 | 0,00805587 | 0,00456416 | 0,09276465 | -0,08820050 | 0,04566245 | -0,05638242 | 0,10204487
90 | 50 | -0,30589108 | -0,30737296 | 0,00148189 | 0,66098110 | 0,65359884 | 0,00738227 | 0,02729677 | 0,06985092 | -0,04255415 | 0,05872755 | -0,06946812 | 0,12819568
112,5 | 50 | -0,30901004 | -0,31095404 | 0,00194401 | 0,65907808 | 0,65503496 | 0,00404310 | 0,05395718 | 0,04391440 | 0,01004277 | 0,06192993 | -0,07273369 | 0,13466361
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
