spaceleagueofjustice/MEMS_Earth_Rotation_Measurement/Project_Jaroslav/Measurement data/T13/T13-3/T13-3_evaluation.xlsx

Sheet: Main
Test ID | T13-3 | Azimuth-Dependence Test (Randomized Step Scan, Off-North Start, Tilted Mount)
Mount azimuth |  |  | 315 | ° | Description: | min X | min Y | max X | max Y
Arm start azimuth |  |  | 0 | ° | - 16*22,5° random position, full 360° - mount azimuth to 315° - start azimuth 0° (north) - measuring plane level - rotation CW
Measuring plane deviation/slope azimuth |  |  | 0 | °/°
Theoretical earth rotation rate |  |  | 0.004178 | °/s
Latitude |  |  | 49 | ° |  | -0.004489 | -0.003357 | 0.004306 | 0.003599
Theoretical earth rotation rate at latitude cos(lat) |  |  | 0.002741 | °/s
Azimuth step |  |  | 22.5 | °
Azimuth step count |  |  | 16
Rotation direction |  |  | CW
Cycles |  |  | 50
Samples per position |  |  | 200
Trim |  |  | 50
Cable protection |  |  | 365 | °
Total samples |  |  | 160000
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
