spaceleagueofjustice/MEMS_Earth_Rotation_Measurement/Project_Jaroslav/Measurement data/T13/T13-3/T13-3_mereni_random_data.csv

cyklus | cilovy_azimut | skutecne_natoceni | jump_deg | trim | xA | yA | axA | ayA | xC | yC | axC | ayC
1 | 225 | -135.00 | -135.00 | 50 | -0.29060000 | 0.59969980 | 0.076675 | -0.003801 | -0.29629996 | 0.60079984 | 0.018091 | -0.008691
2 | 180 | 180.00 | 135.00 | 50 | -0.29560004 | 0.60949990 | 0.066877 | 0.015742 | -0.30215000 | 0.60054992 | 0.029487 | -0.028003
3 | 0 | 360.00 | 0.00 | 50 | -0.30909994 | 0.60874984 | 0.029846 | -0.028230 | -0.28995012 | 0.60750010 | 0.067598 | 0.015884
4 | 22.5 | 22.50 | 22.50 | 50 | -0.29280004 | 0.60799984 | 0.023035 | -0.019836 | -0.29395000 | 0.60464990 | 0.072163 | 0.007253
5 | 270 | 270.00 | 67.50 | 50 | -0.30520004 | 0.60245000 | 0.069431 | -0.024683 | -0.30174994 | 0.62135000 | 0.027114 | 0.012490
6 | 45 | 45.00 | 45.00 | 50 | -0.29004996 | 0.61160000 | 0.019199 | -0.008472 | -0.29370008 | 0.61310000 | 0.076860 | -0.003171
7 | 90 | 90.00 | -135.00 | 50 | -0.29559996 | 0.61800000 | 0.024546 | 0.012847 | -0.28420008 | 0.61214984 | 0.070391 | -0.024319
8 | 247.5 | 247.50 | -22.50 | 50 | -0.29395000 | 0.60275000 | 0.075911 | -0.014634 | -0.28645000 | 0.61375000 | 0.021672 | 0.003003
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
