spaceleagueofjustice/MEMS_Earth_Rotation_Measurement/Project_Jaroslav/Measurement data/T13/T13-3/T13-3_mereni_random_summary.csv

azimut | n | xA_prumer | xC_prumer | diffx_prumer | yA_prumer | yC_prumer | diffy_prumer | axA_prumer | axC_prumer | diffax_prumer | ayA_prumer | ayC_prumer | diffay_prumer
0 | 50 | -0,27962300 | -0,27221400 | -0,00740901 | 0,52801210 | 0,52510500 | 0,00290710 | 0,02739492 | 0,06766358 | -0,04026866 | -0,02916450 | 0,01601357 | -0,04517807
22,5 | 50 | -0,27954104 | -0,27315592 | -0,00638512 | 0,52983100 | 0,52481010 | 0,00502092 | 0,01979190 | 0,07323109 | -0,05343920 | -0,02018931 | 0,00688652 | -0,02707583
45 | 50 | -0,27766898 | -0,27583900 | -0,00182998 | 0,52933100 | 0,52421004 | 0,00512099 | 0,01669087 | 0,07608560 | -0,05939473 | -0,00905908 | -0,00422920 | -0,00482988
67,5 | 50 | -0,27677694 | -0,27606300 | -0,00071394 | 0,53035100 | 0,52315292 | 0,00719804 | 0,01806768 | 0,07494394 | -0,05687626 | 0,00243853 | -0,01573891 | 0,01817744
90 | 50 | -0,27561298 | -0,27892108 | 0,00330809 | 0,53061796 | 0,52505000 | 0,00556797 | 0,02355098 | 0,06915150 | -0,04560053 | 0,01250078 | -0,02581777 | 0,03831855
112,5 | 50 | -0,27459398 | -0,28068100 | 0,00608704 | 0,53078792 | 0,52451308 | 0,00627488 | 0,03328999 | 0,06012680 | -0,02683681 | 0,01979121 | -0,03305200 | 0,05284322
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
