spaceleagueofjustice/MEMS_Earth_Rotation_Measurement/Project_Jaroslav/Measurement data/T13/T13-4/T13-4_mereni_random_data.csv

cyklus | cilovy_azimut | skutecne_natoceni | jump_deg | trim | xA | yA | axA | ayA | xC | yC | axC | ayC
1 | 270 | -90.00 | -90.00 | 50 | -0.32445020 | 0.55419980 | 0.013018 | -0.013894 | -0.29715002 | 0.52815010 | 0.079465 | -0.000229
2 | 157.5 | 157.50 | 67.50 | 50 | -0.30265010 | 0.52449996 | 0.064539 | -0.034304 | -0.29094996 | 0.51455000 | 0.029546 | 0.020400
3 | 112.5 | 112.50 | 112.50 | 50 | -0.28645000 | 0.49335004 | 0.078071 | -0.013435 | -0.27870000 | 0.49225008 | 0.013970 | -0.000525
4 | 45 | 45.00 | 45.00 | 50 | -0.27069990 | 0.49069996 | 0.066465 | 0.020657 | -0.26955004 | 0.46675000 | 0.028125 | -0.034666
5 | 135 | 135.00 | -90.00 | 50 | -0.24374992 | 0.48470000 | 0.075469 | -0.025439 | -0.27664998 | 0.46909984 | 0.017837 | 0.011025
6 | 202.5 | 202.50 | -112.50 | 50 | -0.25710008 | 0.46219990 | 0.039744 | -0.039734 | -0.25715008 | 0.46764984 | 0.053838 | 0.025205
7 | 225 | 225.00 | -157.50 | 50 | -0.26080000 | 0.46954996 | 0.025991 | -0.034812 | -0.26825008 | 0.46120000 | 0.067476 | 0.020618
8 | 180 | -180.00 | -180.00 | 50 | -0.25725000 | 0.45285016 | 0.052793 | -0.039543 | -0.25275000 | 0.45849992 | 0.037605 | 0.025181
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
