spaceleagueofjustice/MEMS_Earth_Rotation_Measurement/Project_Jaroslav/Measurement data/T13/T13-4/T13-4_mereni_random_summary.csv

azimut | n | xA_prumer | xC_prumer | diffx_prumer | yA_prumer | yC_prumer | diffy_prumer | axA_prumer | axC_prumer | diffax_prumer | ayA_prumer | ayC_prumer | diffay_prumer
0 | 50 | -0,25389606 | -0,25323904 | -0,00065702 | 0,45680400 | 0,45336400 | 0,00344002 | 0,03987100 | 0,05325214 | -0,01338113 | 0,02566059 | -0,03889746 | 0,06455805
22,5 | 50 | -0,25598300 | -0,25253292 | -0,00345007 | 0,45677800 | 0,45308196 | 0,00369605 | 0,05167461 | 0,03811260 | 0,01356201 | 0,02565259 | -0,03971733 | 0,06536992
45 | 50 | -0,25495404 | -0,25309998 | -0,00185406 | 0,45905208 | 0,45140296 | 0,00764909 | 0,06343676 | 0,02675952 | 0,03667724 | 0,02059053 | -0,03469512 | 0,05528565
67,5 | 50 | -0,25138196 | -0,25327600 | 0,00189403 | 0,45669096 | 0,45131100 | 0,00537994 | 0,07265117 | 0,01739058 | 0,05526060 | 0,01135361 | -0,02526738 | 0,03662100
90 | 50 | -0,25183696 | -0,25655404 | 0,00471708 | 0,45772300 | 0,45266196 | 0,00506106 | 0,07779756 | 0,01284863 | 0,06494892 | -0,00065537 | -0,01318291 | 0,01252754
112,5 | 50 | -0,24891496 | -0,25596702 | 0,00705205 | 0,45870400 | 0,45586900 | 0,00283504 | 0,07733320 | 0,01285073 | 0,06448247 | -0,01372861 | -0,00005093 | -0,01367768
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
