spaceleagueofjustice/MEMS_Earth_Rotation_Measurement/Project_Jaroslav/Measurement data/T13/T13-5 WRONG/T13-5_mereni_random_data.csv

cyklus | cilovy_azimut | skutecne_natoceni | jump_deg | trim | xA | yA | axA | ayA | xC | yC | axC | ayC
1 | 247.5 | -112.50 | -112.50 | 50 | -0.25395000 | 0.46389990 | 0.046824 | -0.027261 | -0.24924996 | 0.45830016 | 0.042534 | 0.013826
2 | 270 | -90.00 | -157.50 | 50 | -0.25925004 | 0.47334992 | 0.057373 | -0.024878 | -0.25565000 | 0.45839992 | 0.028025 | 0.011384
3 | 225 | 225.00 | 135.00 | 50 | -0.25930000 | 0.48454990 | 0.037222 | -0.026055 | -0.25759996 | 0.47149996 | 0.043076 | 0.013948
4 | 112.5 | 112.50 | 112.50 | 50 | -0.25065002 | 0.45325016 | 0.028022 | 0.006067 | -0.26385004 | 0.47634984 | 0.059653 | -0.019497
5 | 337.5 | 337.50 | 45.00 | 50 | -0.25500000 | 0.47004976 | 0.063943 | -0.004177 | -0.24530002 | 0.46815010 | 0.021528 | -0.008530
6 | 0 | 360.00 | -157.50 | 50 | -0.26090004 | 0.47069988 | 0.064087 | 0.003306 | -0.26260006 | 0.46259990 | 0.030215 | -0.016548
7 | 135 | 135.00 | 135.00 | 50 | -0.25590004 | 0.45645000 | 0.025911 | -0.001887 | -0.27009994 | 0.47114996 | 0.062112 | -0.013171
8 | 292.5 | 292.50 | -22.50 | 50 | -0.25565004 | 0.46854996 | 0.061116 | -0.019160 | -0.25980008 | 0.45344990 | 0.025288 | 0.006323
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
