spaceleagueofjustice/MEMS_Earth_Rotation_Measurement/Project_Jaroslav/Measurement data/T13/T13-5 WRONG/T13-5_mereni_random_summary.csv

azimut | n | xA_prumer | xC_prumer | diffx_prumer | yA_prumer | yC_prumer | diffy_prumer | axA_prumer | axC_prumer | diffax_prumer | ayA_prumer | ayC_prumer | diffay_prumer
0 | 50 | -0,28393300 | -0,27640592 | -0,00752708 | 0,56891000 | 0,57137100 | -0,00246102 | 0,06284454 | 0,02634062 | 0,03650392 | 0,00494780 | -0,01592168 | 0,02086948
22,5 | 50 | -0,28554198 | -0,27747002 | -0,00807196 | 0,56660504 | 0,57172700 | -0,00512195 | 0,05935781 | 0,03294936 | 0,02640844 | 0,01124932 | -0,02241304 | 0,03366236
45 | 50 | -0,28434002 | -0,27757302 | -0,00676700 | 0,56659300 | 0,57184508 | -0,00525206 | 0,05182305 | 0,04015918 | 0,01166387 | 0,01489907 | -0,02621421 | 0,04111328
67,5 | 50 | -0,28412402 | -0,27696600 | -0,00715801 | 0,56604092 | 0,57244390 | -0,00640297 | 0,04382632 | 0,04819527 | -0,00436895 | 0,01554195 | -0,02675142 | 0,04229336
90 | 50 | -0,28310004 | -0,27997798 | -0,00312206 | 0,56450200 | 0,57416992 | -0,00966793 | 0,03549336 | 0,05523623 | -0,01974287 | 0,01295498 | -0,02419600 | 0,03715098
112,5 | 50 | -0,28213196 | -0,28050700 | -0,00162497 | 0,56429800 | 0,57376504 | -0,00946707 | 0,02988555 | 0,06202133 | -0,03213578 | 0,00751655 | -0,01866841 | 0,02618496
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
