spaceleagueofjustice/MEMS_Earth_Rotation_Measurement/Project_Jaroslav/Measurement data/T13/T13-6 WRONG/T13-6_mereni_random_data.csv

cyklus | cilovy_azimut | skutecne_natoceni | jump_deg | trim | xA | yA | axA | ayA | xC | yC | axC | ayC
1 | 45 | 45.00 | 45.00 | 50 | -0.34154984 | 0.75250020 | 0.072288 | -0.010154 | -0.34524984 | 0.75550030 | 0.032498 | 0.002666
2 | 337.5 | 337.50 | 112.50 | 50 | -0.34879980 | 0.75950020 | 0.065623 | 0.012278 | -0.33599990 | 0.75760008 | 0.042251 | -0.019753
3 | 157.5 | 157.50 | 157.50 | 50 | -0.33314990 | 0.74595010 | 0.036501 | -0.020273 | -0.35485010 | 0.75455010 | 0.065627 | 0.012942
4 | 22.5 | 22.50 | 22.50 | 50 | -0.34274996 | 0.75245016 | 0.076658 | -0.001145 | -0.34419984 | 0.76279990 | 0.027109 | -0.006284
5 | 270 | 270.00 | 67.50 | 50 | -0.34279984 | 0.75090000 | 0.041736 | 0.014951 | -0.34324976 | 0.76795000 | 0.061157 | -0.022158
6 | 225 | -135.00 | -135.00 | 50 | -0.34569996 | 0.74430010 | 0.029392 | 0.002417 | -0.34900000 | 0.76080010 | 0.071741 | -0.009895
7 | 0 | 0.00 | -45.00 | 50 | -0.35400008 | 0.75875010 | 0.068032 | 0.005752 | -0.33095002 | 0.75495030 | 0.032185 | -0.013713
8 | 90 | 90.00 | -90.00 | 50 | -0.33999980 | 0.76810000 | 0.060190 | -0.022681 | -0.34689990 | 0.76579990 | 0.042017 | 0.014978
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
