spaceleagueofjustice/MEMS_Earth_Rotation_Measurement/Project_Jaroslav/Measurement data/T13/T13-6 WRONG/T13-6_mereni_random_summary.csv

azimut | n | xA_prumer | xC_prumer | diffx_prumer | yA_prumer | yC_prumer | diffy_prumer | axA_prumer | axC_prumer | diffax_prumer | ayA_prumer | ayC_prumer | diffay_prumer
0 | 50 | -0,30208892 | -0,29866096 | -0,00342795 | 0,64750010 | 0,64266720 | 0,00483292 | 0,06834478 | 0,03066035 | 0,03768443 | 0,00467632 | -0,01393008 | 0,01860640
22,5 | 50 | -0,30046996 | -0,29707192 | -0,00339803 | 0,64642716 | 0,64591308 | 0,00051409 | 0,06986108 | 0,02803336 | 0,04182773 | -0,00344687 | -0,00615425 | 0,00270737
45 | 50 | -0,29925396 | -0,29778802 | -0,00146595 | 0,64779716 | 0,64502116 | 0,00277603 | 0,06907681 | 0,02939478 | 0,03968203 | -0,01176167 | 0,00208633 | -0,01384800
67,5 | 50 | -0,29807090 | -0,29888090 | 0,00081000 | 0,64790210 | 0,64563200 | 0,00227004 | 0,06492466 | 0,03349512 | 0,03142954 | -0,01908101 | 0,00931987 | -0,02840088
90 | 50 | -0,29823200 | -0,30084792 | 0,00261593 | 0,64819500 | 0,64383804 | 0,00435698 | 0,05855670 | 0,04011352 | 0,01844318 | -0,02416162 | 0,01436084 | -0,03852246
112,5 | 50 | -0,29809898 | -0,30192696 | 0,00382799 | 0,64875008 | 0,64505904 | 0,00369102 | 0,05034214 | 0,04796747 | 0,00237466 | -0,02634668 | 0,01655655 | -0,04290323
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
