spaceleagueofjustice/MEMS_Earth_Rotation_Measurement/Project_Jaroslav/Measurement data/T14/T14-1/T14-1_mereni_random_data.csv

cyklus | cilovy_azimut | skutecne_natoceni | jump_deg | trim | xA | yA | axA | ayA | xC | yC | axC | ayC
1 | 45 | 45.00 | 45.00 | 50 | -0.55504996 | 0.99164980 | 0.026274 | -0.026055 | -0.50245004 | 0.91904984 | 0.066902 | 0.013064
2 | 202.5 | 202.50 | 157.50 | 50 | -0.44295000 | 0.84360010 | 0.058730 | 0.019583 | -0.42960020 | 0.81310032 | 0.036560 | -0.031802
3 | 67.5 | 67.50 | -135.00 | 50 | -0.39339996 | 0.76934990 | 0.020122 | -0.016824 | -0.38389996 | 0.74035010 | 0.073584 | 0.004148
4 | 112.5 | 112.50 | 45.00 | 50 | -0.35954988 | 0.72209968 | 0.021763 | 0.004937 | -0.35055008 | 0.70094990 | 0.074150 | -0.017385
5 | 315 | -45.00 | -157.50 | 50 | -0.33754992 | 0.66270008 | 0.066624 | -0.026169 | -0.32785008 | 0.67360000 | 0.027959 | 0.013984
6 | 0 | 0.00 | 45.00 | 50 | -0.31990010 | 0.64529984 | 0.046631 | -0.034753 | -0.30514996 | 0.63229970 | 0.047219 | 0.021758
7 | 22.5 | 22.50 | 22.50 | 50 | -0.31825006 | 0.63879990 | 0.036763 | -0.032119 | -0.30359996 | 0.62824992 | 0.058413 | 0.019797
8 | 225 | -135.00 | -157.50 | 50 | -0.28960008 | 0.60699990 | 0.065649 | 0.012769 | -0.28655008 | 0.60434990 | 0.025972 | -0.026121
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
