spaceleagueofjustice/MEMS_Earth_Rotation_Measurement/Project_Jaroslav/Measurement data/T14/T14-1/T14-1_mereni_random_summary.csv

azimut | n | xA_prumer | xC_prumer | diffx_prumer | yA_prumer | yC_prumer | diffy_prumer | axA_prumer | axC_prumer | diffax_prumer | ayA_prumer | ayC_prumer | diffay_prumer
0 | 25 | -0,26066798 | -0,25460600 | -0,00606197 | 0,52246608 | 0,51992210 | 0,00254399 | 0,04577676 | 0,04742706 | -0,00165030 | -0,03503828 | 0,02245410 | -0,05749238
22,5 | 25 | -0,26008004 | -0,25410602 | -0,00597402 | 0,51996404 | 0,51680400 | 0,00316006 | 0,03445293 | 0,05819267 | -0,02373974 | -0,03271474 | 0,01998691 | -0,05270166
45 | 25 | -0,27179602 | -0,26373004 | -0,00806597 | 0,53644000 | 0,52683190 | 0,00960809 | 0,02563818 | 0,06755246 | -0,04191428 | -0,02639346 | 0,01365664 | -0,04005010
67,5 | 25 | -0,26018800 | -0,25980598 | -0,00038204 | 0,52872410 | 0,52027000 | 0,00845408 | 0,01903281 | 0,07302041 | -0,05398760 | -0,01708447 | 0,00427852 | -0,02136299
90 | 25 | -0,25677000 | -0,25757802 | 0,00080800 | 0,52054600 | 0,51298600 | 0,00756001 | 0,01746797 | 0,07527910 | -0,05781113 | -0,00606240 | -0,00680488 | 0,00074248
112,5 | 25 | -0,26039204 | -0,26305004 | 0,00265801 | 0,52228192 | 0,51990604 | 0,00237590 | 0,01935820 | 0,07300429 | -0,05364609 | 0,00490820 | -0,01769385 | 0,02260205
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
