spaceleagueofjustice/MEMS_Earth_Rotation_Measurement/Project_Jaroslav/Measurement data/T14/T14-2/T14-2_evaluation.xlsx

Sheet: Main
Test ID | T14-2 | Azimuth-Dependence Test (Randomized 360° Step Scan, Off-North Start, Tilted Mount)
Mount azimuth |  |  | 0 | ° | Description/title: | Code:
Arm start azimuth |  |  | 0 | ° | Rotation-direction control test: two runs at the same baseline configuration (level, arm at true north), 25-repeat randomized azimuth sweep each, run once with normal (CW) and once with reversed (CCW) motor rotation direction, to isolate whether the direction of rotation itself introduces a systematic bias into the measured differential signal. | HORIZONTAL slepý test 360-kontrola accel-lepší csv-azimut parametr-fixed trim settle-s navratem do A
Measuring plane deviation/slope azimuth |  |  | 0 | °/°
Theoretical earth rotation rate |  |  | 0.004178 | °/s
Latitude |  |  | 49 | °
Theoretical earth rotation rate at latitude cos(lat) |  |  | 0.002741 | °/s
Azimuth step |  |  | 22.5 | °
Azimuth step count |  |  | 16
Rotation direction |  |  | CCW |  |  | min X | min Y | max X | max Y
Cycles |  |  | 25
Samples per position |  |  | 200
Trim |  |  | 50
Cable protection |  |  | 400 | ° |  | -0.002916 | -0.003900 | 0.002047 | 0.002917
Total samples |  |  | 80000
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
