spaceleagueofjustice/MEMS_Earth_Rotation_Measurement/Project_Jaroslav/Measurement data/T18/T18-1/T18-1_graf1_vsechny_cykly_fit.png

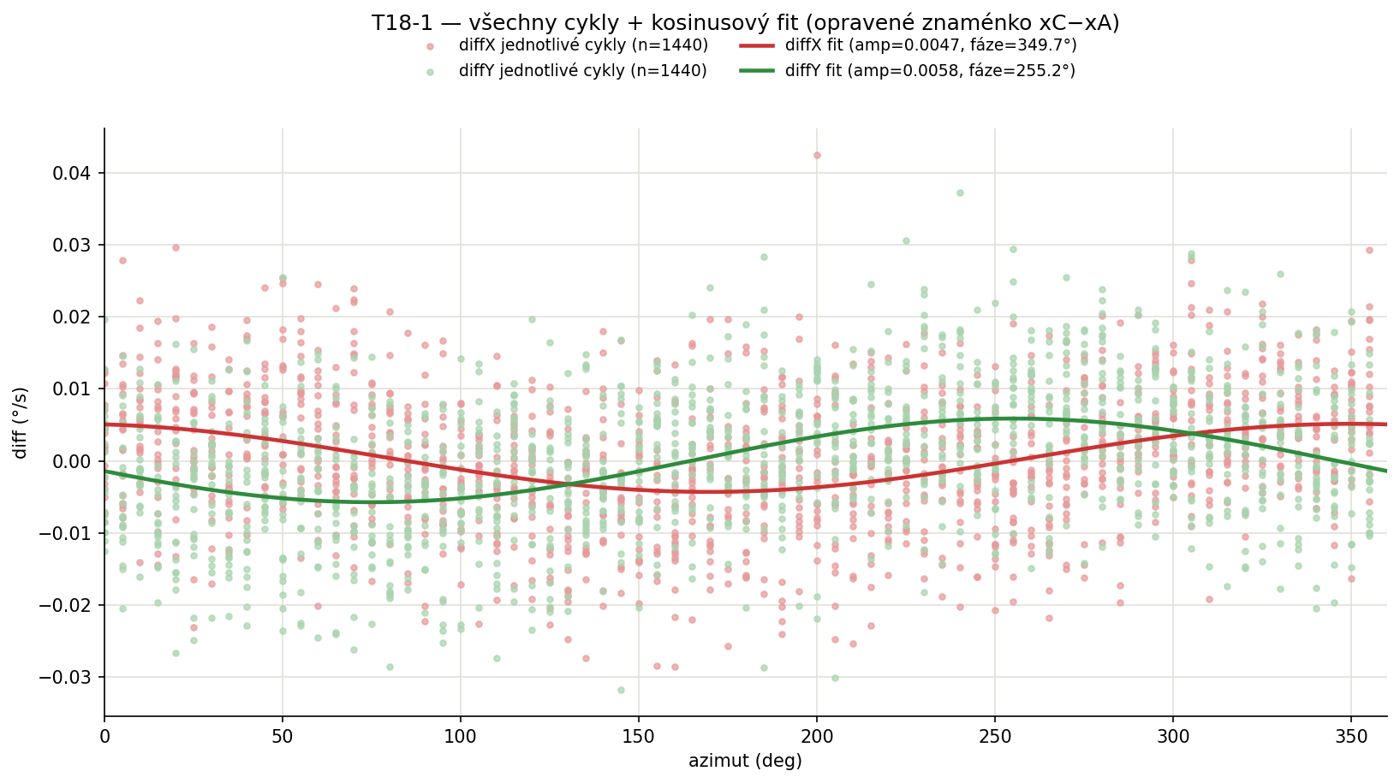
Project_Jaroslav/Measurement data/T18/T18-1/T18-1_graf1_vsechny_cykly_fit.png
