spaceleagueofjustice/MEMS_Earth_Rotation_Measurement/Project_Jaroslav/Measurement data/T18/T18-2/T18-2_graf2_prumery_fit.png

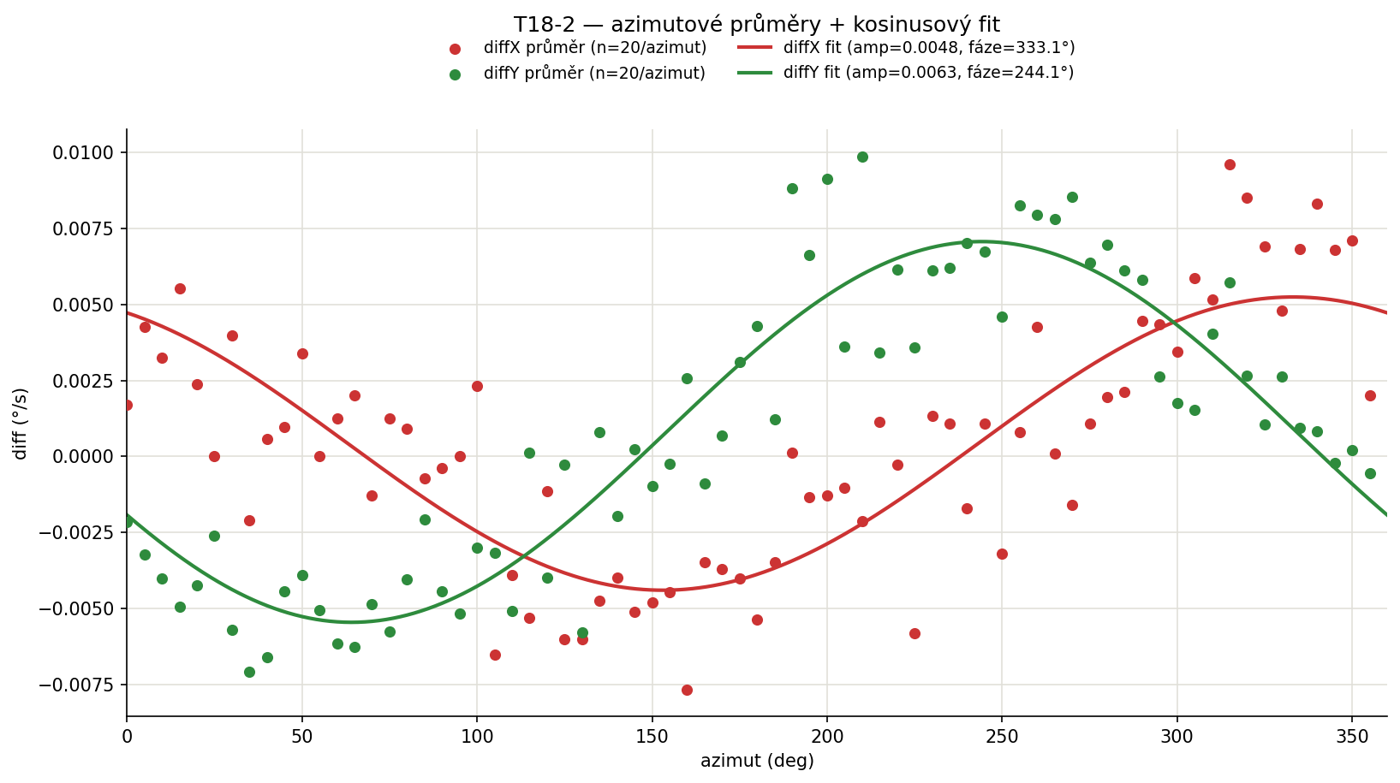
Project_Jaroslav/Measurement data/T18/T18-2/T18-2_graf2_prumery_fit.png
