spaceleagueofjustice/MEMS_Earth_Rotation_Measurement/Project_Jaroslav/Measurement data/T18/T18-2/T18-2_graf3_prumery_spline.png

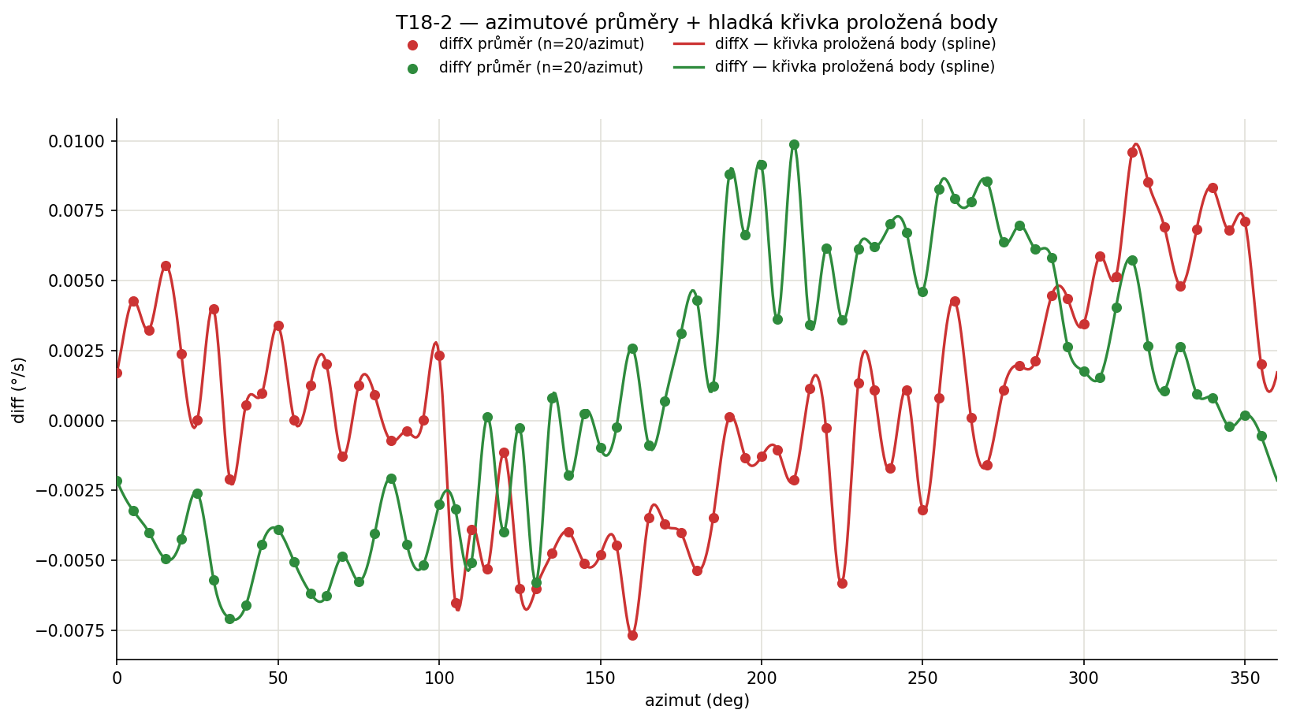
Project_Jaroslav/Measurement data/T18/T18-2/T18-2_graf3_prumery_spline.png
