spaceleagueofjustice/MEMS_Earth_Rotation_Measurement/Project_Jaroslav/Measurement data/T19/T19-3/T19_3_fit_v2.png

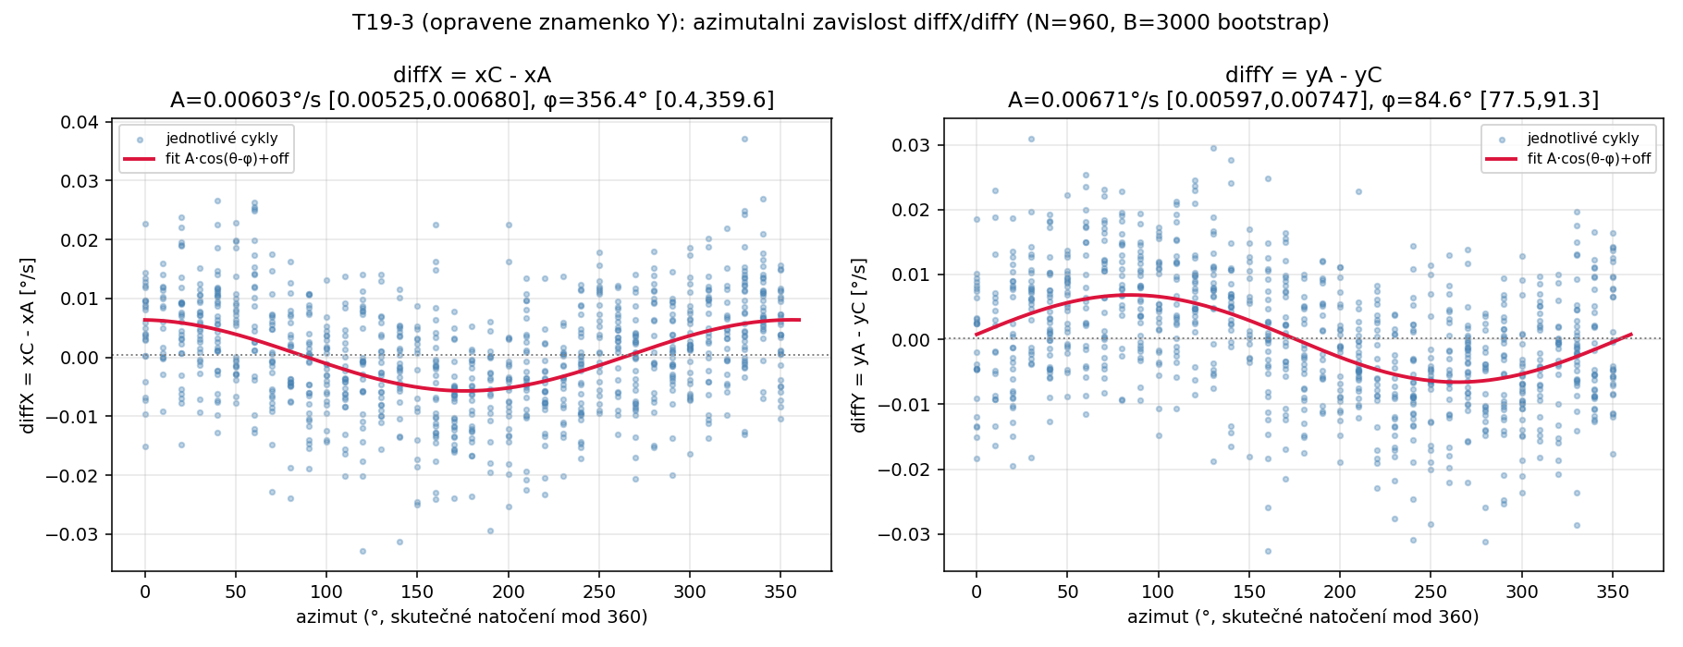
Project_Jaroslav/Measurement data/T19/T19-3/T19_3_fit_v2.png
