spaceleagueofjustice/MEMS_Earth_Rotation_Measurement/Project_Jirka/Diagrams/Sketch_V_1_0_0_1_wiring_diagram_measurement_section.pdf

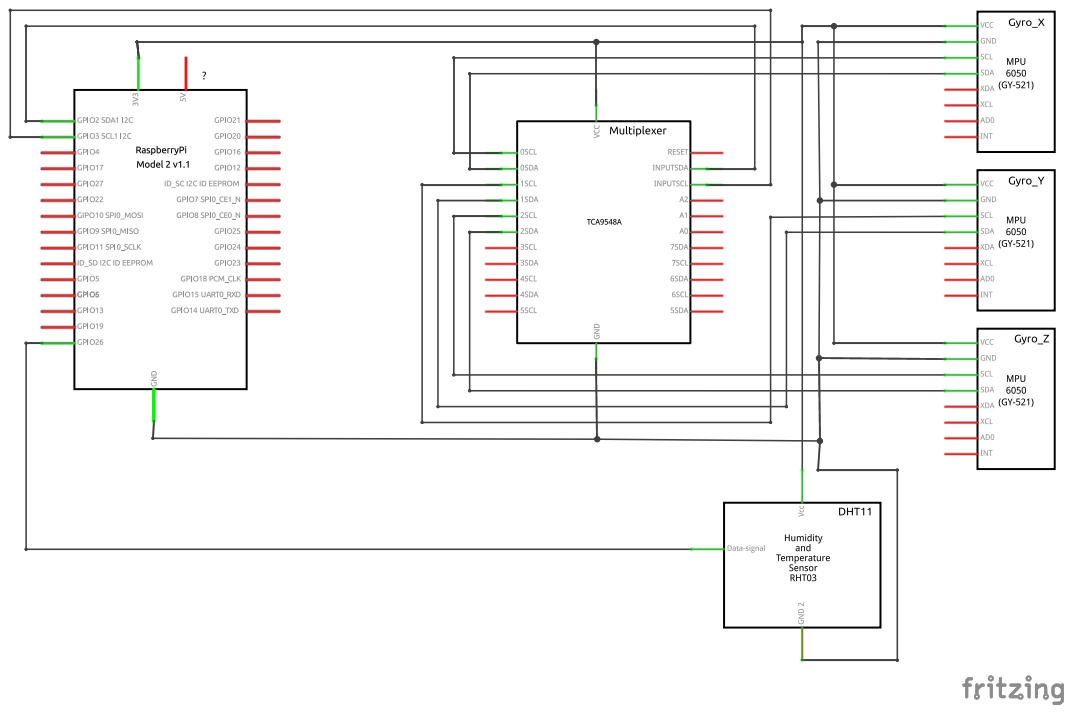
[picture p30: page 1]
